dattewell/center-cluster-esp32-p4/README.md

## Issues/bug fixes

### Older boards/revision errors

This board is P4 v1.3, builds require SELECTS_REV_LESS_V3=y.
