dattewell/center-cluster-esp32-p4/DashRPM.kicad_pcb

## KiCad design DashRPM.kicad_pcb (2026-08-12, last stored version)

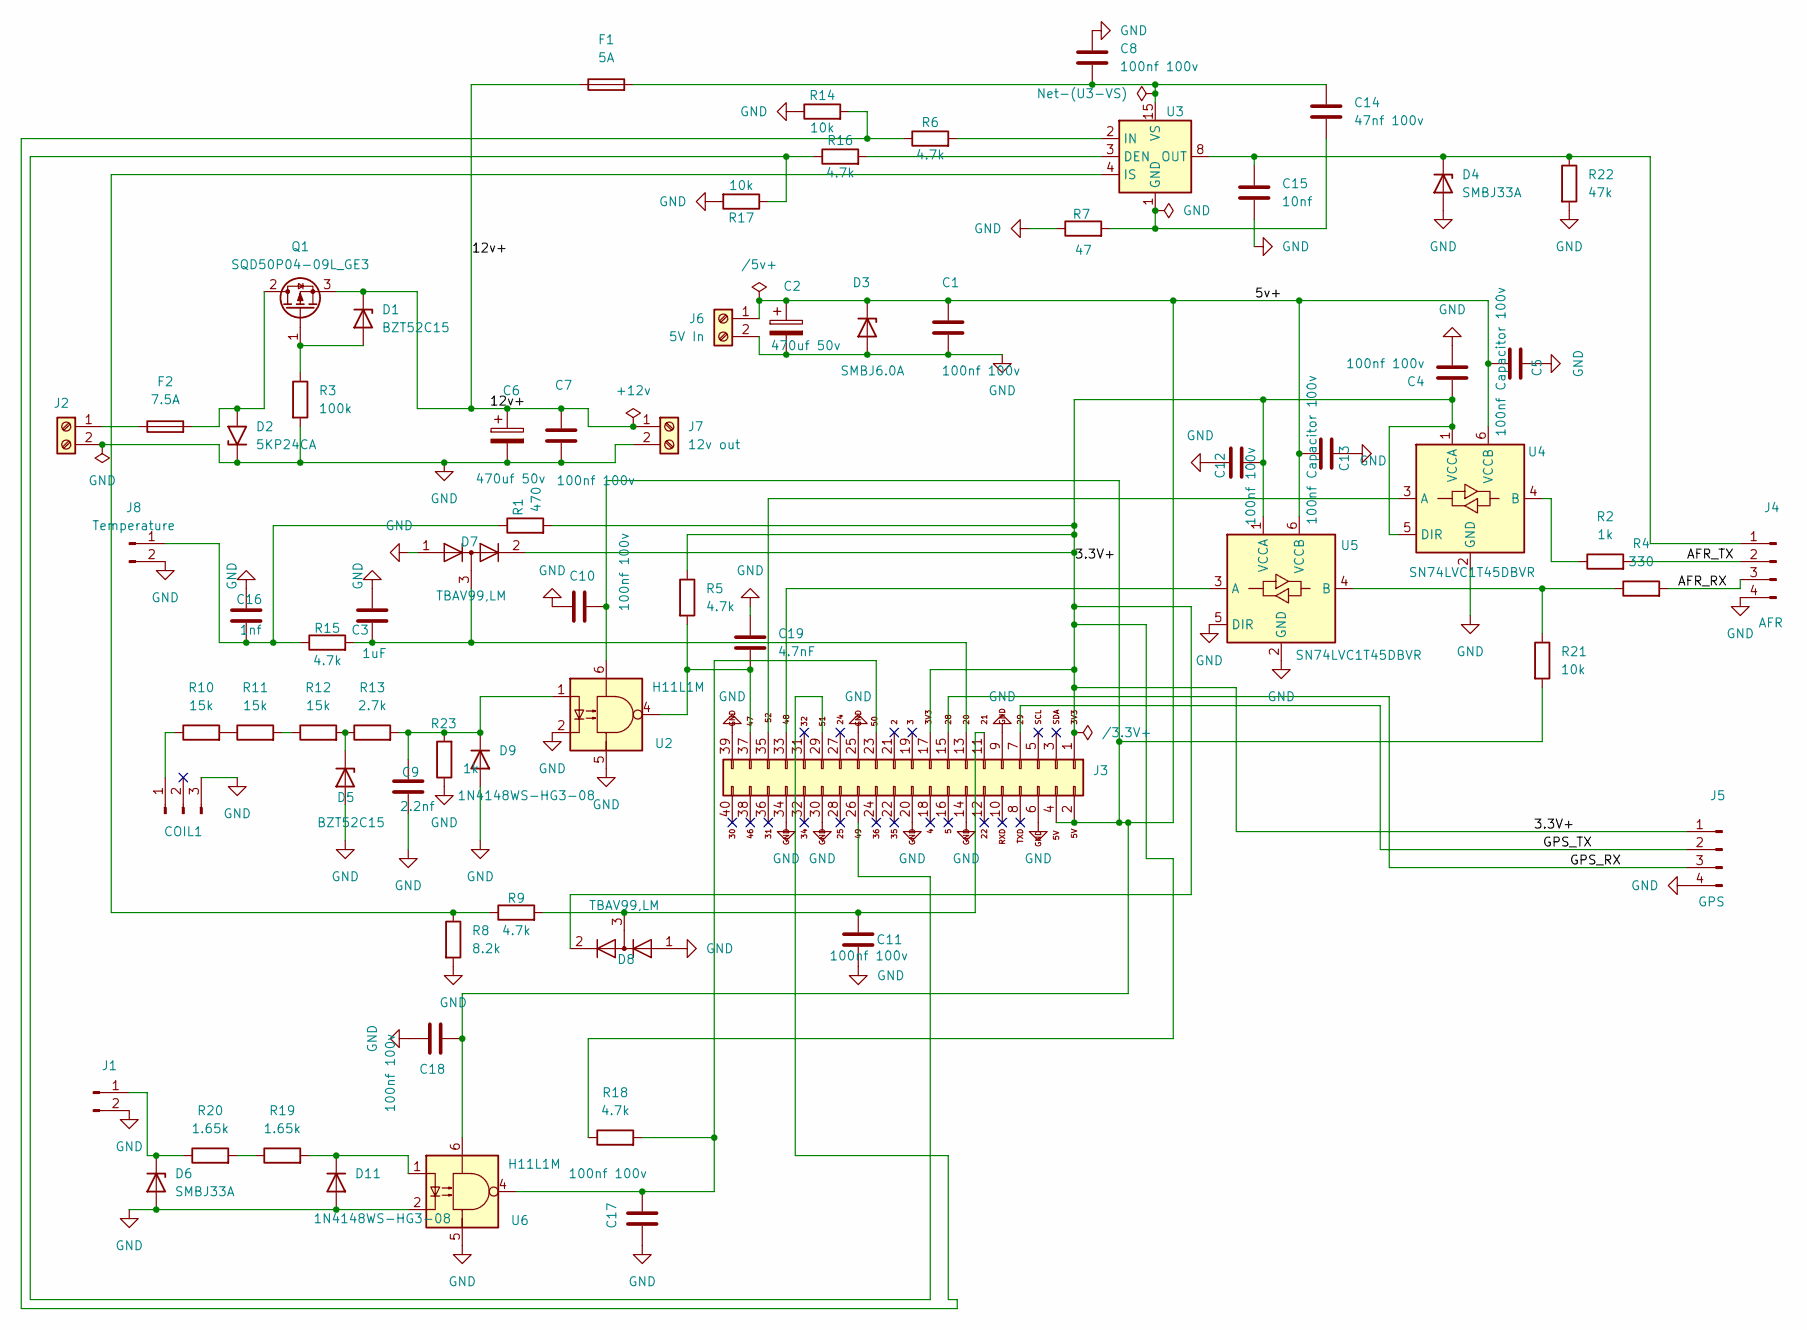
[picture p1: schematic DashRPM.kicad_sch, Morris Minor Dash Display]

Parts:
C1, C4, C5, C7, C8, C10, C11, C12, C13, C17, C18: 100nf 100v; C_0805_2012Metric; LCSC C28233
C2, C6: 470uf 50v; CP_Radial_D10.0mm_P5.00mm; LCSC C713167
C3: 1uF; C_0805_2012Metric; LCSC C28323
C9: 2.2nf; C_0805_2012Metric; LCSC C1728
C14: 47nf 100v; C_0805_2012Metric; LCSC C161267
C15: 10nf; C_0805_2012Metric; LCSC C161265
C16: 1nf; C_0805_2012Metric; LCSC C46653
C19: 4.7nF; C_0805_2012Metric; LCSC C415370
COIL1: Coil; JST_XH_B3B-XH-A_1x03_P2.50mm_Vertical; LCSC C144394
D1, D5: BZT52C15; D_SOD-123; LCSC C27754
D2: 5KP24CA; D_5KP_P12.70mm_Horizontal; LCSC C3704111
D3: SMBJ6.0A; D_SMB; LCSC C83270
D4, D6: SMBJ33A; D_SMB_Handsoldering; LCSC C224019
D7, D8: TBAV99,LM; SOT-23; LCSC C145146
D9, D11: 1N4148WS-HG3-08; D_SOD-323_HandSoldering; LCSC C3313072
F1: 5A; Fuseholder_Blade_Mini_Keystone_3568; LCSC C5249699
F2: 7.5A; Fuseholder_Blade_Mini_Keystone_3568; LCSC C5249699
J1: Headlight; JST_XH_B2B-XH-A_1x02_P2.50mm_Vertical; LCSC C158012
J2: 12v In; TerminalBlock_MaiXu_MX126-5.0-02P_1x02_P5.00mm; LCSC C3820334
J3: To Display; IDC-Header_2x20_P2.54mm_Vertical; LCSC C9138
J4: AFR; JST_VH_B4P-VH_1x04_P3.96mm_Vertical; LCSC C160317
J5: GPS; JST_XH_B4B-XH-A_1x04_P2.50mm_Vertical; LCSC C144395
J6: 5V In; TerminalBlock_MaiXu_MX126-5.0-02P_1x02_P5.00mm; LCSC C3820334
J7: 12v out; TerminalBlock_MaiXu_MX126-5.0-02P_1x02_P5.00mm; LCSC C3820334
J8: Temperature; JST_XH_B2B-XH-A_1x02_P2.50mm_Vertical; LCSC C158012
Q1: SQD50P04-09L_GE3; TO-252-3_TabPin2; LCSC C5160151
R1: 470; R_0805_2012Metric_Pad1.20x1.40mm_HandSolder; LCSC C491182
R2, R23: 1k; R_0805_2012Metric_Pad1.20x1.40mm_HandSolder; LCSC C191555
R3: 100k; R_0805_2012Metric_Pad1.20x1.40mm_HandSolder; LCSC C191554
R4: 330; R_0805_2012Metric_Pad1.20x1.40mm_HandSolder; LCSC C2479687
R5, R6, R9, R15, R16, R18: 4.7k; R_0805_2012Metric_Pad1.20x1.40mm_HandSolder; LCSC C473295
R7: 47; R_0805_2012Metric_Pad1.20x1.40mm_HandSolder; LCSC C490799
R8: 8.2k; R_0805_2012Metric_Pad1.20x1.40mm_HandSolder; LCSC C445657
R10, R11, R12: 15k; R_2512_6332Metric_Pad1.40x3.35mm_HandSolder; LCSC C965951
R13: 2.7k; R_0805_2012Metric_Pad1.20x1.40mm_HandSolder; LCSC C409999
R14, R17: 10k; R_1206_3216Metric_Pad1.30x1.75mm_HandSolder; LCSC C6492313
R19, R20: 1.65k; R_1206_3216Metric_Pad1.30x1.75mm_HandSolder; LCSC C2482762
R21: 10k; R_0805_2012Metric_Pad1.20x1.40mm_HandSolder; LCSC C191101
R22: 47k; R_0805_2012Metric_Pad1.20x1.40mm_HandSolder; LCSC C441957
U2, U6: H11L1M; SMDIP-6_W7.62mm; LCSC C16587
U3: BTS7004-1EPP; Infineon_PG-TSDSO-14-22; LCSC C534825
U4, U5: SN74LVC1T45DBVR; SOT-23-6; LCSC C7843

Connections:
/3.3V+: C4.1, C12.1, D7.2 (A), D8.2 (A), J3.1 (3V3), J3.17 (3V3), J5.1, R1.2, R5.1, R18.1, U4.1 (VCCA), U4.5 (DIR), U5.1 (VCCA)
/5v+: C1.1, C2.1, C5.2, C10.2, C13.2, C18.1, D3.1 (K), J3.2 (5V), J3.4 (5V), J6.1, R21.2, U2.6, U4.6 (VCCB), U5.6 (VCCB), U6.6
/12v+: C6.1, C7.1, D1.1 (K), F1.1, J7.1, Q1.3 (S)
/AFR_RX: J4.3, R4.2
/AFR_TX: J4.2, R2.2
/GPS_RX: J3.15 (28), J5.3
/GPS_TX: J3.7 (29), J5.2
GND: C1.2, C2.2, C3.1, C4.2, C5.1, C6.2, C7.2, C8.1, C9.2, C10.1, C11.1, C12.2, C13.1, C15.2, C16.1, C17.1, C18.2, C19.1, COIL1.3, D2.1 (A1), D3.2 (A), D4.2 (A), D5.2 (A), D6.2 (A), D7.1 (K), D8.1 (K), D9.2 (A), D11.2 (A), J1.2, J2.2, J3.6 (GND), J3.9 (GND), J3.14 (GND), J3.20 (GND), J3.25 (GND), J3.30 (GND), J3.34 (GND), J3.39 (GND), J4.4, J5.4, J6.2, J7.2, J8.2, R3.2, R7.1, R8.2, R14.1, R17.2, R22.2, R23.1, U2.2, U2.5, U4.2 (GND), U5.2 (GND), U5.5 (DIR), U6.2, U6.5
unnamed: COIL1.1, R10.1
unnamed: D1.2 (A), Q1.1 (G), R3.1
unnamed: D2.2 (A2), F2.2, Q1.2 (D)
unnamed: C15.1, D4.1 (K), J4.1, R22.1, U3.8 (OUT), U3.9 (OUT), U3.10 (OUT), U3.12 (OUT), U3.13 (OUT), U3.14 (OUT)
unnamed: D5.1 (K), R12.2, R13.1
unnamed: D6.1 (K), J1.1, R20.1
unnamed: C9.1, D9.1 (K), R13.2, R23.2, U2.1
unnamed: D11.1 (K), R19.2, U6.1
unnamed: F2.1, J2.1
unnamed: C3.2, D7.3 (K), J3.13 (20), R15.2
unnamed: C11.2, D8.3 (K), J3.11 (21), R9.2
unnamed: C19.2, J3.37 (47), R5.2, U2.4
unnamed: J3.33 (48), U5.3 (A)
unnamed: J3.26 (49), R16.1, R17.1
unnamed: C17.2, J3.23 (50), R18.2, U6.4
unnamed: J3.29 (51), R6.1, R14.2
unnamed: J3.35 (52), U4.3 (A)
unnamed: C16.2, J8.1, R1.1, R15.1
unnamed: R10.2, R11.1
unnamed: R11.2, R12.1
unnamed: R19.1, R20.2
unnamed: R16.2, U3.3 (DEN)
unnamed: C14.2, R7.2, U3.1 (GND)
unnamed: R6.2, U3.2 (IN)
unnamed: R8.1, R9.1, U3.4 (IS)
unnamed: C8.2, C14.1, F1.2, U3.15 (VS)
unnamed: R2.1, U4.4 (B)
unnamed: R4.1, R21.1, U5.4 (B)

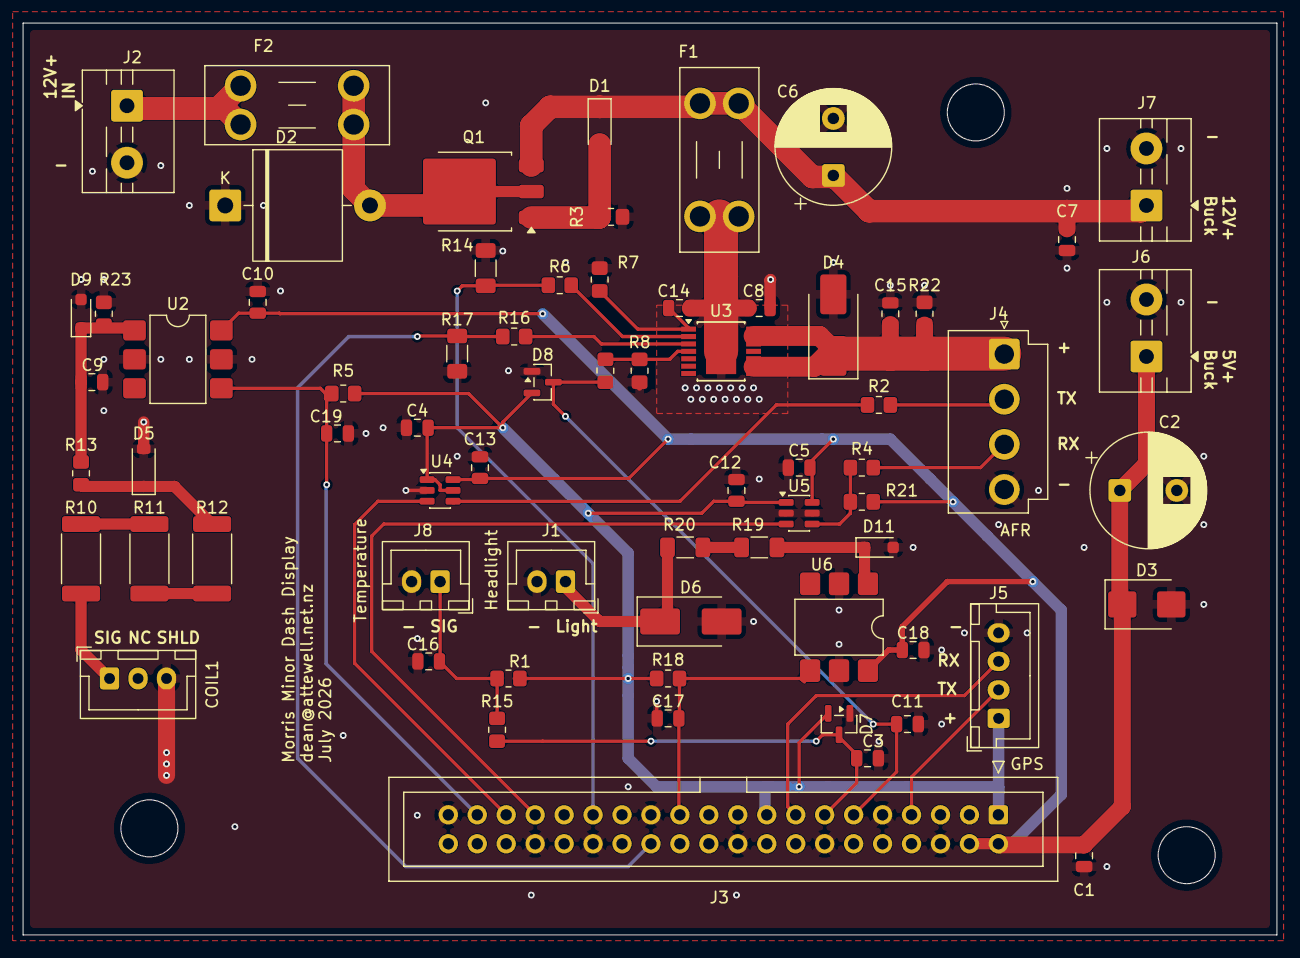
[picture p2: board DashRPM.kicad_pcb from above]

Board: 2 copper layers, 110.0 x 80.0 mm, 69 parts (0 on the bottom side), 36 nets.
