dattewell/center-cluster-esp32-p4/main/main.c

#include "freertos/FreeRTOS.h"
#include "freertos/task.h"
#include "freertos/queue.h"
#include "nvs_flash.h"
#include "nvs.h"
#include "esp_log.h"
#include "esp_err.h"
#include "esp_check.h"
#include "esp_memory_utils.h"
#include "bsp/esp-bsp.h"
#include "bsp/display.h"
#include "bsp_board_extra.h"
#include "lvgl.h"
#include "lv_demos.h"
#include "ui.h"
#include "driver/uart.h"
#include "driver/gpio.h"
#include <string.h>
#include <stdint.h>
#include <stdlib.h>
#include <stdio.h>
#include <ctype.h>
#include <math.h>
#include <time.h>
#include <unistd.h>
#include "esp_adc/adc_oneshot.h"
#include "esp_adc/adc_cali.h"
#include "esp_adc/adc_cali_scheme.h"
#include "driver/pulse_cnt.h"
#include "esp_timer.h"
#include "gps_wrapper.h"
#include "odometer/odometer.h"
#include "esp_core_dump.h"
#include "esp_flash.h"


//-------------Build / feature flags-------------//
#define ENABLE_LOGS true
#define ADC_UPDATE_PERIOD_MS 10
#define FILTER_SAMPLES_DEFAULT 8

// DEMO_MODE used to live here as a compile-time flag. It's now g_demo_mode
// (below, near g_afr_enabled) - a runtime toggle driven by ui_DemoSwitch on
// the Settings screen via ChangeDemoMode(), not a rebuild.

// Crash-dump relay + debug-log-tee to the SD card (see below). Was
// temporarily disabled (2026-08-12) while isolating a taskLVGL deadlock in
// lv_draw_add_task - root cause was LV_MEM_SIZE exhaustion (see lv_conf.h),
// unrelated to this code. Re-enabled now that's fixed.
#define SD_FEATURES_ENABLED 1
//------------------------------------------------//

//-------------GPS (u-blox M10)-------------//
// GPS RX/TX per netlist (/GPS_TX net = J3 pin 7 = GPIO29 = ESP RX;
// /GPS_RX net = J3 pin 15 = GPIO28 = ESP TX). Net names are from the
// module's perspective, so ESP_RX reads the net called GPS_TX and vice versa.
#define GPS_RX_PIN        29
#define GPS_UART_NUM      UART_NUM_3
#define GPS_TX_PIN        28
#define GPS_BAUD_RATE     38400
#define GPS_BUF_SIZE      1024
#define GPS_MIN_VALID_MPH 3.0f
//-------------------------------------------//

//-------------RPM (coil/distributor via H11L1 optoisolator) - GPIO 47-------------//
#define RPM_PULSE_GPIO       47
#define RPM_PULSES_PER_REV   2      // 4-cyl, 4-stroke: cylinders / 2
#define RPM_SAMPLE_MS        250    // how often the pulse count is turned into an RPM figure

// RPM dial angle range, calibrated against the dial artwork.
#define RPM_NEEDLE_ANGLE_0RPM     (710)
#define RPM_NEEDLE_ANGLE_MAX_RPM  (2910)
#define RPM_DIAL_MAX_RPM          6000
//----------------------------------------------------------------------------------//

//-------------Headlight sense (GPIO50) - dims the display at night-------------//
// Active LOW per the H11L1 opto (U6): HIGH = headlights off, LOW = on. Board
// already has an external 4k7 pull-up (R18), so no internal pull needed.
// Debounced in software - a bad earth or a flash-to-pass must not flicker
// the display - and brightness ramps smoothly between day/night levels
// rather than stepping, per CLAUDE.md Sec.6's suggested behaviour.
#define HEADLIGHT_GPIO          50
#define HEADLIGHT_DEBOUNCE_MS   300
#define BRIGHTNESS_DAY_PCT      50   // matches the existing boot default
#define BRIGHTNESS_NIGHT_PCT    40
#define BRIGHTNESS_RAMP_MS      1000
//--------------------------------------------------------------------------------//

//-------------AFR power gating (BTS7004 on GPIO51)-------------//
// The AFR UART level shifter used to be a single TXB0104D with a
// software-controlled OE pin (AFR_OE_GPIO, was GPIO28). The schematic now
// uses two single-bit SN74LVC1T45 shifters (one per UART direction) with
// their DIR pins hardwired to GND - fixed-direction, no enable pin at all,
// so translation just follows whichever side has power. That power already
// comes from the same BTS7004 rail this gate switches, so there's nothing
// left for a GPIO to enable here.
//
// GPIO51 drives U3 (BTS7004-1EPP) pin 2, IN, per netlist (Net-(J3-51):
// R14.2, R6.1 -> U3.2). GPIO4 was tried earlier and is physically
// unconnected on this board (terminates at J3 pin 18, no further net) - it
// would have silently done nothing.
#define AFR_ENABLE_GPIO      51     // BTS7004-1EPP IN - powers the AFR sensor
// Not yet wired into control logic - defined for when DEN/IS support is added.
#define AFR_DEN_GPIO         49     // BTS7004-1EPP DEN - HIGH enables IS output
#define AFR_IS_ADC_CHANNEL   ADC_CHANNEL_5  // BTS7004-1EPP IS, ADC1_CH5 (GPIO21)
#define RPM_MIN_RUNNING      500    // must be at/above this to start qualifying AFR power-on
#define RPM_QUALIFY_MS       30000  // sustained duration above RPM_MIN_RUNNING before AFR powers on
#define RPM_STOPPED_BELOW    100    // below this is treated as "engine stopped", not just idling low
#define RPM_STOPPED_HOLD_MS  5000   // sustained duration below RPM_STOPPED_BELOW before AFR powers back off
//-------------------------------------------------------------------------------------//

//-------------AFR UART (14point7 Spartan)-------------//
// TX/RX assignment per schematic: AFR_TX on U4 (GPIO52), AFR_RX on U5 (GPIO48).
#define AFR_UART_NUM   UART_NUM_1
#define AFR_TX_PIN     52
#define AFR_RX_PIN     48
#define AFR_BAUD_RATE  9600
//--------------------------------------------------------------------//

//-------------ADC (shared by coolant temp + PROFET current sense, both ADC1)-------------//
#define ADC_WIDTH ADC_BITWIDTH_12
#define ADC_ATTEN ADC_ATTEN_DB_12
//------------------------------------------------------------------------------------------//

//-------------Coolant temperature (GPIO20 / ADC1_CH4)-------------//
// Coolant temp - GPIO20, ADC1_CHANNEL4, per netlist (Net-(J3-20): C3.2,
// D7.3, R15.2). Confirmed on ADC1, not ADC2.
#define WATER_TEMP_ADC_CHANNEL ADC_CHANNEL_4
#define TEMP_UPDATE_DELAY 250 // 4 updates a second

// Sender node: SENSOR_SUPPLY --[R_PULLUP]-- (node, straight into the ADC pin,
// no external divider) --[sender]-- GND, with a 100nF cap on the node for
// noise filtering. R_PULLUP is R1, ERJU6RD4700V (470R) per netlist/BOM -
// confirmed authoritative over both the 1k the schematic trace suggested and
// the 10k firmware previously assumed.
#define R_PULLUP       470.0f
#define SENSOR_SUPPLY  3.3f

// NTC Beta-model conversion per CLAUDE.md Sec.3 - sender is R25=730R,
// Beta=3763 (25/85C). Physics-based, accurate across the sender's whole
// -10C to 120C+ range, unlike a table fitted only to a handful of measured
// points.
#define TEMP_R25_OHMS   730.0f
#define TEMP_BETA       3763.0f
#define TEMP_T0_KELVIN  298.15f

// Fault detection thresholds — derived from R_PULLUP = 470R.
// A working sender at -10C reads ~2946 mV, so 3000 would false-trigger;
// 3150 keeps clean margin below that while still catching a genuine open
// (~3300 mV). Coldest expected reading is ~2.95 V (-10 C); hottest ~0.12 V (150 C).
#define TEMP_OPEN_MV    3150    // sender disconnected / broken wire
#define TEMP_SHORT_MV     40    // sender or wire shorted to ground
#define TEMP_R_INVALID  -1.0f
//--------------------------------------------------------------------//

//-------------Speedo (mph) needle angles-------------//
// Matches the initial lv_image_set_rotation() set on ui_SpeedoNeedle in ui_MainSpeedo.c (0 mph rest position).
#define SPEEDO_NEEDLE_REST_ANGLE   (-670)
// How far the sweep rotates from rest before returning; sign/magnitude tuned by eye
// against the dial artwork to land near the 80 mph mark, since this needle has no
// existing mph->angle calibration to derive it from.
#define SPEEDO_SWEEP_ANGLE_DELTA   (2455)
// Needle angle at 80 mph (the top of the dial's marked scale) for live gauge
// readings - distinct from SPEEDO_SWEEP_ANGLE_DELTA above, which deliberately
// overshoots past this for the boot-time sweep flourish.
#define SPEEDO_NEEDLE_ANGLE_80MPH  (2110)
//------------------------------------------------------//

//-------------LOGGING------------//
static const char *TAG_TEMP = "TEMP_SENSOR";
static const char *TAG_GPS = "GPS_SENSOR";
static const char *TAG_AFR = "AFR_SENSOR";
//--------------------------------//

//------------DATA_SENT_OUT---------//
// Internal, display-friendly gauge model.  Every producer path writes these
// engineering-unit values first, then the UART packet layer scales them to the
// fixed-point protocol expected by the remote gauge display.
typedef struct {
    float water_temp_c;
    bool  water_temp_valid;  // false when the sender reads as disconnected - see TEMP_OPEN_MV/TEMP_SHORT_MV
    float afr;
    float afr_temp_c;   // wideband sensor cell temperature - drives update_afr_status()
    float speed_mph;
    int   rpm;
} gauge_data_t;

static gauge_data_t g_gauge_data;

// Set by update_afr_power_gate(), read by afr_task() - true once the AFR
// sensor's power (BTS7004) and UART level shifter (TXB0104D) are enabled.
// Deliberately NOT touched by demo mode below - this reflects the real,
// physical heater GPIO state, driven only by real RPM, regardless of what's
// on screen. See afr_should_display_enabled() for the display-only concern.
static volatile bool g_afr_enabled = false;

// Runtime demo-mode toggle (ui_DemoSwitch on the Settings screen, wired via
// ChangeDemoMode() below). Always starts false - deliberately not persisted
// to NVS, so a power cycle never leaves the dash stuck showing synthetic
// swept values instead of real sensor data.
static volatile bool g_demo_mode = false;

// The AFR gauge should render as "active" both when the sensor is genuinely
// powered (g_afr_enabled) and while demo mode is sweeping it for a bench
// test - but demo mode must never touch g_afr_enabled itself, since that
// also drives the real PROFET heater GPIO (see update_afr_power_gate()).
static bool afr_should_display_enabled(void) {
    return g_afr_enabled || g_demo_mode;
}


//---------------------------------------//

typedef struct {
    lv_obj_t *value_label;
    lv_obj_t *mirror_label; // optional duplicate label on another screen showing the same text, or NULL
    lv_obj_t *needle;
    const char *log_tag;
    int16_t angle_min;
    int16_t angle_max;
    int decimals;   // decimal places shown in the value label
} gauge_channel_t;

// Updates a gauge's value label(s) and needle angle together, but only if the
// displayed value actually changed (avoids redundant redraws every tick).
static void update_gauge_channel(const gauge_channel_t *ch, float new_value, int16_t angle){
    char buf[12];
    snprintf(buf, sizeof(buf), "%.*f", ch->decimals, new_value);

    // Only update text if changed
    const char *old_text = lv_label_get_text(ch->value_label);
    if (strcmp(old_text, buf) == 0) return;

    lv_label_set_text(ch->value_label, buf);
    if (ch->mirror_label) lv_label_set_text(ch->mirror_label, buf);

    if (angle > ch->angle_max) angle = ch->angle_max;
    if (angle < ch->angle_min) angle = ch->angle_min;
    #if ENABLE_LOGS
        ESP_LOGI(ch->log_tag, "value=%.1f angle=%d", new_value, angle);
    #endif
    lv_image_set_rotation(ch->needle, angle);
}

//-------------------------AFR sensor (LSU ADV) temperature status-------------------------//
// Thresholds per the LSU ADV element's operating spec: below 350C the
// controller is still waiting out the condensation phase (no valid data);
// 350-730C the heater is ramping; 730-820C is the element's rated operating
// range (AFR valid); 820-900C the heater has backed off and exhaust heat
// alone is pushing the cell hotter than rated, so AFR is still shown but
// flagged; above 900C is an alarm condition and AFR should be treated as
// unreliable.
#define AFR_TEMP_HEATING_C     350.0f
#define AFR_TEMP_OPERATING_C   730.0f
#define AFR_TEMP_WARNING_HOT_C 820.0f
#define AFR_TEMP_TOO_HOT_C     900.0f
#define AFR_ALARM_BLINK_MS     500

#define AFR_STATUS_COLOR_GOOD    0x14A604
#define AFR_STATUS_COLOR_BAD     0xF80303
#define AFR_STATUS_COLOR_WARNING 0xE0954B

typedef enum {
    AFR_TEMP_STATE_COLD,
    AFR_TEMP_STATE_HEATING,
    AFR_TEMP_STATE_OPERATING,
    AFR_TEMP_STATE_WARNING_HOT,
    AFR_TEMP_STATE_TOO_HOT,
} afr_temp_state_t;

static afr_temp_state_t afr_classify_temp(float temp_c) {
    if (temp_c < AFR_TEMP_HEATING_C)     return AFR_TEMP_STATE_COLD;
    if (temp_c < AFR_TEMP_OPERATING_C)   return AFR_TEMP_STATE_HEATING;
    if (temp_c < AFR_TEMP_WARNING_HOT_C) return AFR_TEMP_STATE_OPERATING;
    if (temp_c < AFR_TEMP_TOO_HOT_C)     return AFR_TEMP_STATE_WARNING_HOT;
    return AFR_TEMP_STATE_TOO_HOT;
}

static const char *afr_temp_state_word(afr_temp_state_t state) {
    switch (state) {
        case AFR_TEMP_STATE_COLD:        return "Cold";
        case AFR_TEMP_STATE_HEATING:      return "Heating";
        case AFR_TEMP_STATE_OPERATING:    return "Operating";
        case AFR_TEMP_STATE_WARNING_HOT:  return "Warning Hot";
        default:                          return "Too Hot";
    }
}

static uint32_t afr_temp_state_color(afr_temp_state_t state) {
    switch (state) {
        case AFR_TEMP_STATE_OPERATING:   return AFR_STATUS_COLOR_GOOD;
        case AFR_TEMP_STATE_WARNING_HOT: return AFR_STATUS_COLOR_WARNING;
        default:                         return AFR_STATUS_COLOR_BAD;
    }
}

// Converts the latest AFR reading to the AFR needle's angle range and refreshes
// the AFR label/needle (mirrored onto ui_AfrV2 on the RPM/AFR screen).
// Shows "--" instead while the AFR sensor isn't powered on at all (g_afr_enabled
// false - no sustained RPM, see update_afr_power_gate()), or blanks both labels
// whenever ui_AFRStatusBad is the one lit up (Cold/Heating/Too Hot - see
// update_afr_status()), since the reading is unreliable in all three of those
// bands, not just Too Hot. Takes the already-classified temperature state (see
// gauge_timer) rather than reclassifying it itself, since update_afr_status()
// needs the same classification.

// AFR gauge angle range, calibrated against the dial artwork.
#define AFR_GAUGE_MIN_VALUE    10.0f
#define AFR_GAUGE_MAX_VALUE    18.0f
#define AFR_NEEDLE_ANGLE_MIN   860
#define AFR_NEEDLE_ANGLE_MAX   1650

static void update_afr(float new_value, afr_temp_state_t afr_state){
    if (!afr_should_display_enabled()) {
        if (strcmp(lv_label_get_text(ui_AfrV), "--") != 0) {
            lv_label_set_text(ui_AfrV, "--");
            lv_label_set_text(ui_AfrV2, "--");
        }
        lv_obj_add_flag(ui_AfrD, LV_OBJ_FLAG_HIDDEN);
        return;
    }

    if (afr_state != AFR_TEMP_STATE_OPERATING && afr_state != AFR_TEMP_STATE_WARNING_HOT) {
        if (strcmp(lv_label_get_text(ui_AfrV), "") != 0) {
            lv_label_set_text(ui_AfrV, "");
            lv_label_set_text(ui_AfrV2, "");
        }
        lv_obj_add_flag(ui_AfrD, LV_OBJ_FLAG_HIDDEN);
        return;
    }

    lv_obj_remove_flag(ui_AfrD, LV_OBJ_FLAG_HIDDEN);
    int16_t afr_angle = (int16_t)((new_value - AFR_GAUGE_MIN_VALUE) * (AFR_NEEDLE_ANGLE_MAX - AFR_NEEDLE_ANGLE_MIN)
        / (AFR_GAUGE_MAX_VALUE - AFR_GAUGE_MIN_VALUE) + AFR_NEEDLE_ANGLE_MIN);
    gauge_channel_t ch = { .value_label = ui_AfrV, .mirror_label = ui_AfrV2, .needle = ui_AfrD, .log_tag = "AFR", .angle_min = AFR_NEEDLE_ANGLE_MIN, .angle_max = AFR_NEEDLE_ANGLE_MAX, .decimals = 1 };
    update_gauge_channel(&ch, new_value, afr_angle);
}

// Edge-detects a data source going from valid to invalid, so callers can run
// their "blank the display" step exactly once per invalid streak instead of
// every tick. Callers seed their static bool `true` so the very first call
// also forces a blank (clearing SquareLine's design-time placeholder text).
static bool valid_state_dropped(bool *was_valid, bool is_valid_now) {
    bool dropped = !is_valid_now && *was_valid;
    *was_valid = is_valid_now;
    return dropped;
}

// Converts the latest water temp reading to the temp needle's angle range and
// refreshes the temp label/needle.

// Water temp gauge angle range, calibrated against the dial artwork.
#define TEMP_GAUGE_MIN_VALUE     40.0f
#define TEMP_GAUGE_MAX_VALUE     120.0f
#define TEMP_NEEDLE_ANGLE_MIN    1950
#define TEMP_NEEDLE_ANGLE_MAX    2760

static void update_water_temp(float new_value, bool valid){
    static bool last_valid = true;

    if (valid_state_dropped(&last_valid, valid)) {
        lv_label_set_text(ui_TempV, "--");
    }
    if (!valid) {
        lv_obj_add_flag(ui_TempD, LV_OBJ_FLAG_HIDDEN);
        return;
    }

    lv_obj_remove_flag(ui_TempD, LV_OBJ_FLAG_HIDDEN);
    int16_t temp_angle = (int16_t)(TEMP_NEEDLE_ANGLE_MAX - (new_value - TEMP_GAUGE_MIN_VALUE)
        * (TEMP_NEEDLE_ANGLE_MAX - TEMP_NEEDLE_ANGLE_MIN) / (TEMP_GAUGE_MAX_VALUE - TEMP_GAUGE_MIN_VALUE));
    gauge_channel_t ch = { .value_label = ui_TempV, .mirror_label = NULL, .needle = ui_TempD, .log_tag = "TEMP", .angle_min = TEMP_NEEDLE_ANGLE_MIN, .angle_max = TEMP_NEEDLE_ANGLE_MAX, .decimals = 0 };
    update_gauge_channel(&ch, new_value, temp_angle);
}

// Converts the latest RPM reading to the RPM dial's angle range and refreshes
// the RPM label/needle.
static void update_rpm(int rpm){
    int16_t rpm_angle = (int16_t)(RPM_NEEDLE_ANGLE_0RPM +
        (int32_t)rpm * (RPM_NEEDLE_ANGLE_MAX_RPM - RPM_NEEDLE_ANGLE_0RPM) / RPM_DIAL_MAX_RPM);
    gauge_channel_t ch = { .value_label = ui_RpmV, .mirror_label = NULL, .needle = ui_RpmD, .log_tag = "RPM", .angle_min = RPM_NEEDLE_ANGLE_0RPM, .angle_max = RPM_NEEDLE_ANGLE_MAX_RPM, .decimals = 0 };
    update_gauge_channel(&ch, rpm, rpm_angle);
}

// Drives the three AFR sensor-temperature widgets from one classification:
//  - ui_AFRStatusBad: "Cold"/"Heating" (red) below the rated range, blinking
//    "Too Hot" (red) above it, blank in between (Operating/Warning Hot).
//  - ui_AFRStatusGood: "Operating" (green) in the rated range, "Warning Hot"
//    (amber) just above it (AFR still valid but flagged), blank otherwise.
//  - ui_AFRStatus: always-on combined "<state>\n<temp>C" readout, one word
//    per band (Cold/Heating/Operating/Warning Hot/Too Hot) colored to match.
// All three are blanked outright while the AFR sensor isn't powered on at all
// (g_afr_enabled false - no sustained RPM, see update_afr_power_gate()), since
// there's no real temperature reading to classify yet. Takes the
// already-classified state (see gauge_timer) since update_afr() needs the
// same classification - no need to derive it twice per tick.
static void update_afr_status(float temp_c, afr_temp_state_t state) {
    // ui_AFRStatusBad and ui_AFRStatusGood's dedupe checks always land on the
    // same "did the state change since last call" answer, so one tracker
    // covers both - only was_enabled needs to stay separate (see below).
    static afr_temp_state_t last_state = (afr_temp_state_t)-1;
    static bool blink_on = false;
    static int64_t last_blink_ms = 0;
    static char last_status_text[24] = "";
    // Starts true so the very first call (with g_afr_enabled still false at
    // boot) forces an initial blank, clearing SquareLine's design-time
    // placeholder text ("Heating\n360C" etc.) instead of leaving it on-screen
    // until the sensor happens to cycle enabled->disabled once. Kept distinct
    // from last_state (rather than checking last_state == -1) because that
    // sentinel is also last_state's own "unset" value - collapsing the two
    // would suppress this initial forced blank.
    static bool was_enabled = true;

    if (valid_state_dropped(&was_enabled, afr_should_display_enabled())) {
        lv_label_set_text(ui_AFRStatusGood, "");
        lv_label_set_text(ui_AFRStatusBad, "");
        lv_label_set_text(ui_AFRStatus, "");
        last_state = (afr_temp_state_t)-1;
        last_status_text[0] = '\0';
    }
    if (!afr_should_display_enabled()) return;

    bool state_changed = (state != last_state);
    #if ENABLE_LOGS
        if (state_changed) {
            ESP_LOGI(TAG_AFR, "temp state %d -> %d (%.0fC)", last_state, state, temp_c);
        }
    #endif

    // ui_AFRStatusBad: Cold/Heating shown solid, Too Hot blinks as an alarm,
    // Operating/Warning Hot leave it blank.
    if (state == AFR_TEMP_STATE_COLD || state == AFR_TEMP_STATE_HEATING) {
        if (state_changed) {
            lv_label_set_text(ui_AFRStatusBad, afr_temp_state_word(state));
        }
    } else if (state == AFR_TEMP_STATE_TOO_HOT) {
        int64_t now_ms = esp_timer_get_time() / 1000;
        if (now_ms - last_blink_ms >= AFR_ALARM_BLINK_MS) {
            last_blink_ms = now_ms;
            blink_on = !blink_on;
            lv_label_set_text(ui_AFRStatusBad, blink_on ? "Too Hot" : "");
        }
    } else if (state_changed) {
        lv_label_set_text(ui_AFRStatusBad, "");
    }

    // ui_AFRStatusGood: Operating/Warning Hot shown, blank otherwise.
    if (state_changed) {
        if (state == AFR_TEMP_STATE_OPERATING || state == AFR_TEMP_STATE_WARNING_HOT) {
            lv_label_set_text(ui_AFRStatusGood, afr_temp_state_word(state));
            lv_obj_set_style_text_color(ui_AFRStatusGood, lv_color_hex(afr_temp_state_color(state)), LV_PART_MAIN | LV_STATE_DEFAULT);
        } else {
            lv_label_set_text(ui_AFRStatusGood, "");
        }
    }
    last_state = state;

    // ui_AFRStatus: always-on combined readout.
    char status_text[24];
    snprintf(status_text, sizeof(status_text), "%s\n%.0f\xC2\xB0" "C", afr_temp_state_word(state), temp_c);
    if (strcmp(status_text, last_status_text) != 0) {
        lv_label_set_text(ui_AFRStatus, status_text);
        lv_obj_set_style_text_color(ui_AFRStatus, lv_color_hex(afr_temp_state_color(state)), LV_PART_MAIN | LV_STATE_DEFAULT);
        strncpy(last_status_text, status_text, sizeof(last_status_text) - 1);
        last_status_text[sizeof(last_status_text) - 1] = '\0';
    }
}
//--------------------------------------------------------------------------------------------//

// Updates one odometer digit label, but only if it differs from what's
// currently shown.
static void update_odo_if_needed(lv_obj_t *label, int digit) {
    char new_value[2] = { (char)('0' + digit), '\0' };
    const char *old_text = lv_label_get_text(label);
    if (strcmp(old_text, new_value) != 0) {
        #if ENABLE_LOGS
            ESP_LOGI("ODOMETER", "old_text=%s new_value=%s", old_text, new_value);
        #endif
        lv_label_set_text(label, new_value);
    }
}

//-----------------------TEMP--------------------------//

float read_temp_resistance(int millivolts) {
    if (millivolts >= TEMP_OPEN_MV || millivolts <= TEMP_SHORT_MV) {
        return TEMP_R_INVALID;
    }
    float v = millivolts / 1000.0f;
    return R_PULLUP * (v / (SENSOR_SUPPLY - v));
}

//-----------------------------------------------------//

void update_odometer(int miles) {
    static int last_miles = -1;
    if (miles != last_miles) {
        last_miles = miles;
        #if ENABLE_LOGS
            ESP_LOGI("ODOMETER", "miles=%d", miles);
        #endif    // Loop through each of the 6 odometer labels and update them with the corresponding digit
        lv_obj_t *odo_labels[6] = {
            ui_Odometer1, ui_Odometer2, ui_Odometer3, ui_Odometer4, ui_Odometer5, ui_Odometer6
        };
        int divisor = 100000;  // hundred-thousands down to units
        for (int i = 0; i < 6; i++) {
            update_odo_if_needed(odo_labels[i], (miles / divisor) % 10);
            divisor /= 10;
        }
    }
}

// km/h gauge angle range, calibrated against the dial artwork. Needle angle
// decreases as speed increases (starts at KMH_NEEDLE_ANGLE_MAX for 0 km/h).
#define KMH_GAUGE_MAX_VALUE     105.0f
#define KMH_NEEDLE_ANGLE_MIN    -590
#define KMH_NEEDLE_ANGLE_MAX    615

// Refreshes the mph/km-h speed labels and needles. Shows "--" on both while
// GPS has no fix, since a stale/zero speed reading would otherwise look like
// a real value; and de-jitters near-zero GPS noise by treating anything
// below GPS_MIN_VALID_MPH as stationary.
void update_speedo(float speed_mph, bool has_fix) {
    static int last_speed = -1;
    static bool last_fix = true;

    if (valid_state_dropped(&last_fix, has_fix)) {
        lv_label_set_text(ui_SpeedoValue, "--");
        lv_label_set_text(ui_SpeedV, "--");
        lv_label_set_text(ui_SpeedV2, "--");
        // Needles otherwise stay frozen at whatever angle they last showed
        // (e.g. mid-sweep from demo mode) instead of returning to 0, since
        // the angle update below is skipped entirely once !has_fix returns.
        lv_image_set_rotation(ui_SpeedoNeedle, SPEEDO_NEEDLE_REST_ANGLE);
        lv_image_set_rotation(ui_SpeedD, KMH_NEEDLE_ANGLE_MAX);
        last_speed = -1;   // force a redraw once the fix comes back
    }
    if (!has_fix) return;

    if (speed_mph < GPS_MIN_VALID_MPH) speed_mph = 0.0f;
    int speed_int = (int)speed_mph;

    if (speed_int != last_speed) {
        int16_t mph_angle = (int16_t)(SPEEDO_NEEDLE_REST_ANGLE +
            speed_mph * (SPEEDO_NEEDLE_ANGLE_80MPH - SPEEDO_NEEDLE_REST_ANGLE) / 80);
        gauge_channel_t ch = { .value_label = ui_SpeedoValue, .mirror_label = NULL, .needle = ui_SpeedoNeedle, .log_tag = "Mph_Speed", .angle_min = SPEEDO_NEEDLE_REST_ANGLE, .angle_max = SPEEDO_NEEDLE_ANGLE_80MPH, .decimals = 0 };
        update_gauge_channel(&ch, speed_mph, mph_angle);

        int speed_kmh = (int)(speed_mph * 1.609344f);
        int16_t kmh_angle = (int16_t)(KMH_NEEDLE_ANGLE_MAX
            + speed_kmh * (KMH_NEEDLE_ANGLE_MIN - KMH_NEEDLE_ANGLE_MAX) / KMH_GAUGE_MAX_VALUE);
        gauge_channel_t ch2 = { .value_label = ui_SpeedV, .mirror_label = ui_SpeedV2, .needle = ui_SpeedD, .log_tag = "Kmh_Speed", .angle_min = KMH_NEEDLE_ANGLE_MIN, .angle_max = KMH_NEEDLE_ANGLE_MAX, .decimals = 0 };
        update_gauge_channel(&ch2, speed_kmh, kmh_angle );

        last_speed = speed_int;
    }
}

// Defined further down alongside the rest of the GPS/timezone handling;
// forward-declared here so gauge_timer (and update_gps_time_display) can use it.
static bool gps_get_nz_local_time(struct tm *out_nz_tm);

// Refreshes the GPS local-time labels (ui_TimeV / ui_TimeV2), blanking both
// while GPS doesn't have a valid time yet.
static void update_gps_time_display(void) {
    // Starts true so the very first call (before GPS has any fix) forces an
    // initial blank, clearing SquareLine's design-time placeholder text
    // ("16:45") instead of leaving it on-screen until GPS time happens to
    // go valid then invalid once.
    static bool last_valid = true;
    static int last_hour = -1;
    static int last_min = -1;
    static int64_t last_check_ms = 0;

    // gps_get_nz_local_time() does two setenv()+tzset() calls, which are
    // genuinely expensive - GPS time only advances ~1x/sec, so there's no
    // point paying that cost on every 10ms gauge_timer tick.
    int64_t now_ms = esp_timer_get_time() / 1000;
    if (now_ms - last_check_ms < 500) return;
    last_check_ms = now_ms;

    struct tm nz_tm;
    bool valid = gps_get_nz_local_time(&nz_tm);
    bool was_valid_before = last_valid;

    if (valid_state_dropped(&last_valid, valid)) {
        lv_label_set_text(ui_TimeV, "");
        lv_label_set_text(ui_TimeV2, "");
        last_hour = -1;
        last_min = -1;   // force a redraw once time comes back
    }
    if (!valid) return;

    // One-time real-world anchor for uptime-stamped logs (including the SD
    // debug log, which debug_log_tee_vprintf() mirrors this into automatically
    // - no SD-specific code needed here). Logged once per validity streak, not
    // every tick, same as the display update below.
    if (!was_valid_before) {
        ESP_LOGI(TAG_GPS, "GPS time acquired: %04d-%02d-%02d %02d:%02d:%02d NZT, uptime=%lldms",
                 nz_tm.tm_year + 1900, nz_tm.tm_mon + 1, nz_tm.tm_mday,
                 nz_tm.tm_hour, nz_tm.tm_min, nz_tm.tm_sec, (long long)now_ms);
    }

    if (nz_tm.tm_hour != last_hour || nz_tm.tm_min != last_min) {
        char buf[6];
        snprintf(buf, sizeof(buf), "%02d:%02d", nz_tm.tm_hour, nz_tm.tm_min);
        lv_label_set_text(ui_TimeV, buf);
        lv_label_set_text(ui_TimeV2, buf);
        last_hour = nz_tm.tm_hour;
        last_min = nz_tm.tm_min;
    }
}

// Reads the debounced headlight state and smoothly ramps display brightness
// between day/night levels (HEADLIGHT_DEBOUNCE_MS/BRIGHTNESS_RAMP_MS above).
// Re-targeting mid-ramp (e.g. a quick on/off/on) starts from wherever the
// brightness currently is, not the old target, so it never jumps.
static void update_brightness(void) {
    static bool raw_last = false;
    static bool headlights_on = false;
    static int64_t debounce_since_ms = 0;
    static int ramp_from_pct = BRIGHTNESS_DAY_PCT;
    static int ramp_to_pct = BRIGHTNESS_DAY_PCT;
    static int64_t ramp_start_ms = 0;
    static int last_applied_pct = -1;

    int64_t now_ms = esp_timer_get_time() / 1000;
    bool raw_on = (gpio_get_level(HEADLIGHT_GPIO) == 0);   // active LOW

    if (raw_on != raw_last) {
        raw_last = raw_on;
        debounce_since_ms = now_ms;
    }

    int64_t elapsed = now_ms - ramp_start_ms;
    int current_pct = (elapsed >= BRIGHTNESS_RAMP_MS)
        ? ramp_to_pct
        : ramp_from_pct + (int)((int64_t)(ramp_to_pct - ramp_from_pct) * elapsed / BRIGHTNESS_RAMP_MS);

    if ((now_ms - debounce_since_ms) >= HEADLIGHT_DEBOUNCE_MS && raw_on != headlights_on) {
        headlights_on = raw_on;
        ramp_from_pct = current_pct;
        ramp_to_pct = headlights_on ? BRIGHTNESS_NIGHT_PCT : BRIGHTNESS_DAY_PCT;
        ramp_start_ms = now_ms;
        current_pct = ramp_from_pct;
        #if ENABLE_LOGS
            ESP_LOGI("BRIGHTNESS", "headlights_on=%d -> ramping %d%% to %d%%", headlights_on, ramp_from_pct, ramp_to_pct);
        #endif
    }

    if (current_pct != last_applied_pct) {
        bsp_display_brightness_set(current_pct);
        last_applied_pct = current_pct;
    }
}

void gauge_timer(lv_timer_t * t) {
    // UI-only timer.  Sensor tasks update shared state; this timer formats the
    // values for LVGL and smooths visual movement such as the RPM arc.

    //update ODOMETER
    int miles = odometer_get_miles();
    update_odometer(miles);

    // update brightness (headlight sense)
    update_brightness();

    // update AFR
    afr_temp_state_t afr_state = afr_classify_temp(g_gauge_data.afr_temp_c);
    update_afr(g_gauge_data.afr, afr_state);
    update_afr_status(g_gauge_data.afr_temp_c, afr_state);

    //update temp
    update_water_temp(g_gauge_data.water_temp_c, g_gauge_data.water_temp_valid);

    //update speed
    update_speedo(g_gauge_data.speed_mph, g_demo_mode ? true : gps_has_fix());

    //update RPM
    update_rpm(g_gauge_data.rpm);

    //update GPS time
    update_gps_time_display();
}

//------------------------------------------------------------------------//



// NTC Beta-model conversion (CLAUDE.md Sec.3): R25=730R, Beta=3763.
float resistance_to_C(float R) {
    float inv_t = 1.0f / TEMP_T0_KELVIN + logf(R / TEMP_R25_OHMS) / TEMP_BETA;
    return 1.0f / inv_t - 273.15f;
}



//---------------------------------GPS------------------------//

void save_miles_task(void *arg){
    // Persisting every meter would wear NVS quickly.  The odometer module only
    // commits after its distance threshold, and this task gives it regular
    // chances to do that work.
    while (1){
        odometer_periodic_save();
        vTaskDelay(pdMS_TO_TICKS(3000));
    }
}

//-------------------------------AFR (14point7 Spartan)-------------------------------//
#define AFR_POLL_PERIOD_MS      200
#define AFR_RESPONSE_TIMEOUT_MS 300

// GETDEFINITIONS replies with one line per field, not a single field-name
// list, e.g.:
//   0,a,i,-,A/F,14P7 A/F,AFR,7,20,
//   1,a,i,-,LSU T,14P7 LSU T,C,710,850,
//   2,a,i,-,DebugAIC,14P7 DbgAIC,,1,100,
//   3,a,i,-,DebugIp,14P7 DbgIp,,1,100
// as <index>,<type>,<io>,<->,<short_name>,<long_name>,<unit>,<min>,<max>,
// The leading index is exactly the field index used by "G" below, so rather
// than inferring order from text position, this just remembers which line's
// index mentioned "A/F"/"AFR" (or "LSU" for the sensor cell temperature).
// Not every unit necessarily has a channel called that, so these defaults
// (matching the real capture above) are kept as a fallback.
static int afr_field_index = 0;
static int afr_temp_field_index = 1;

// Case-insensitive substring search. Not using strcasestr() here - it isn't
// reliably declared by this toolchain's <string.h> without extra feature-test
// macros (the same issue bit timegm() earlier), so a small hand-rolled
// version avoids that risk entirely.
static const char *afr_stristr(const char *haystack, const char *needle) {
    if (!*needle) return haystack;
    for (; *haystack; haystack++) {
        const char *h = haystack;
        const char *n = needle;
        while (*h && *n && tolower((unsigned char)*h) == tolower((unsigned char)*n)) {
            h++;
            n++;
        }
        if (!*n) return haystack;
    }
    return NULL;
}

// Scans a (possibly multi-line) GETDEFINITIONS reply for the lines describing
// the AFR and sensor-temperature channels and records their indices. Logs
// what it found either way.
static void afr_parse_definitions(const char *text) {
    char copy[400];
    strncpy(copy, text, sizeof(copy) - 1);
    copy[sizeof(copy) - 1] = '\0';

    char *saveptr = NULL;
    char *line = strtok_r(copy, "\r\n", &saveptr);
    bool found_afr = false, found_temp = false;

    while (line != NULL) {
        if (!found_afr && (afr_stristr(line, "A/F") || afr_stristr(line, "AFR"))) {
            afr_field_index = atoi(line);
            found_afr = true;
            #if ENABLE_LOGS
                ESP_LOGI(TAG_AFR, "Discovered AFR field at index %d: %s", afr_field_index, line);
            #endif
        } else if (!found_temp && afr_stristr(line, "LSU")) {
            afr_temp_field_index = atoi(line);
            found_temp = true;
            #if ENABLE_LOGS
                ESP_LOGI(TAG_AFR, "Discovered sensor temp field at index %d: %s", afr_temp_field_index, line);
            #endif
        }
        line = strtok_r(NULL, "\r\n", &saveptr);
    }

    #if ENABLE_LOGS
        if (!found_afr) {
            ESP_LOGW(TAG_AFR, "GETDEFINITIONS didn't mention A/F or AFR - keeping default field index %d", afr_field_index);
        }
        if (!found_temp) {
            ESP_LOGW(TAG_AFR, "GETDEFINITIONS didn't mention LSU temp - keeping default field index %d", afr_temp_field_index);
        }
    #endif
}

typedef struct {
    bool afr_valid;
    float afr;
    bool temp_valid;
    float temp_c;
} afr_reading_t;

// "G" replies with one line per field too, as <index>:<type>:<value>, e.g.:
//   0:a:50.0
//   1:a:780
//   2:a:4789
//   3:a:2242
// This scans those lines for the ones matching afr_field_index/afr_temp_field_index
// (as found by afr_parse_definitions()) and returns their values.
static bool afr_parse_g_response(const char *text, afr_reading_t *out) {
    out->afr_valid = false;
    out->temp_valid = false;

    char copy[400];
    strncpy(copy, text, sizeof(copy) - 1);
    copy[sizeof(copy) - 1] = '\0';

    char *saveptr = NULL;
    char *line = strtok_r(copy, "\r\n", &saveptr);

    while (line != NULL) {
        int idx;
        char type;
        float value;
        if (sscanf(line, "%d:%c:%f", &idx, &type, &value) == 3) {
            if (idx == afr_field_index) {
                out->afr = value;
                out->afr_valid = true;
            } else if (idx == afr_temp_field_index) {
                out->temp_c = value;
                out->temp_valid = true;
            }
        }
        line = strtok_r(NULL, "\r\n", &saveptr);
    }
    return out->afr_valid || out->temp_valid;
}

// Sends an AFR command and waits for its reply, returning the number of
// bytes received (0 on timeout) with buf null-terminated either way.
static int afr_send_command(const char *cmd, uint8_t *buf, size_t buf_size) {
    uart_write_bytes(AFR_UART_NUM, cmd, strlen(cmd));
    int len = uart_read_bytes(AFR_UART_NUM, buf, buf_size - 1, pdMS_TO_TICKS(AFR_RESPONSE_TIMEOUT_MS));
    if (len < 0) len = 0;
    buf[len] = '\0';
    return len;
}

// Sends an AFR setup command and logs its reply under `tag`, if any.
static void afr_send_and_log(const char *cmd, const char *tag, uint8_t *buf, size_t buf_size) {
    if (afr_send_command(cmd, buf, buf_size) > 0) {
        #if ENABLE_LOGS
            ESP_LOGI(TAG_AFR, "%s: %s", tag, (char *)buf);
        #endif
    }
}

void afr_task(void *arg) {
    // Request/response protocol, not a continuous stream: only talks to the
    // Spartan while g_afr_enabled (set by update_afr_power_gate once RPM has
    // qualified). On the first poll after power-on, runs a one-time setup
    // sequence (identify the unit, configure slow-heat protection, and
    // discover the AFR field's index), then polls with "G" from then on.
    uint8_t buf[400];
    bool queried_definitions = false;

    while (1) {
        if (!g_afr_enabled) {
            queried_definitions = false;
            vTaskDelay(pdMS_TO_TICKS(500));
            continue;
        }

        if (!queried_definitions) {
            // Give the sensor/level shifter a moment to come up cleanly.
            vTaskDelay(pdMS_TO_TICKS(200));

            afr_send_and_log("GETHW\r\n", "GETHW", buf, sizeof(buf));
            afr_send_and_log("GETFW\r\n", "GETFW", buf, sizeof(buf));

            // Our power gate (update_afr_power_gate()) enables the sensor
            // once RPM has merely been sustained for 30s, which doesn't
            // guarantee the exhaust near the sensor bung is hot yet - this
            // tells the controller to wait (up to 10 min) for exhaust gas to
            // reach 350C before driving the heater, avoiding thermal shock.
            afr_send_and_log("SETSLOWHEAT3\r\n", "SETSLOWHEAT3", buf, sizeof(buf));

            if (afr_send_command("GETDEFINITIONS\r\n", buf, sizeof(buf)) > 0) {
                #if ENABLE_LOGS
                    ESP_LOGI(TAG_AFR, "GETDEFINITIONS: %s", (char *)buf);
                #endif
                afr_parse_definitions((char *)buf);
            } else {
                #if ENABLE_LOGS
                    ESP_LOGW(TAG_AFR, "No response to GETDEFINITIONS - keeping default field order");
                #endif
            }
            queried_definitions = true;
        }

        if (afr_send_command("G\r\n", buf, sizeof(buf)) > 0) {
            afr_reading_t reading;
            if (afr_parse_g_response((char *)buf, &reading)) {
                // Gated so a real, already-powered AFR sensor (g_afr_enabled
                // true from sustained real RPM) can't race demo_task's
                // synthetic writes to the same fields if demo mode gets
                // toggled on mid-drive. See adc_task/gps_task for the same
                // pattern.
                if (!g_demo_mode) {
                    if (reading.afr_valid)  g_gauge_data.afr = reading.afr;
                    if (reading.temp_valid) g_gauge_data.afr_temp_c = reading.temp_c;
                }
                #if ENABLE_LOGS
                    ESP_LOGI(TAG_AFR, "G: %s -> afr=%.2f temp=%.0fC", (char *)buf, g_gauge_data.afr, g_gauge_data.afr_temp_c);
                #endif
            } else {
                #if ENABLE_LOGS
                    ESP_LOGW(TAG_AFR, "Unparsable G response: %s", (char *)buf);
                #endif
            }
        }

        vTaskDelay(pdMS_TO_TICKS(AFR_POLL_PERIOD_MS));
    }
}
//--------------------------------------------------------------------------------------//

#define NZ_TZ "NZST-12NZDT-13,M9.5.0,M4.1.0/3"

// Converts a GPS UTC date/time into NZ local time (NZST/NZDT), DST included,
// using the C library's POSIX TZ rule instead of hand-rolled calendar math.
//
// newlib here doesn't expose timegm(), so instead of a direct UTC->epoch
// conversion, mktime() is used with TZ briefly forced to UTC0 (mktime()
// interprets its input using whatever the current TZ is), then TZ is
// restored to NZ time for the localtime_r() conversion. This isn't
// reentrant-safe against another task reading local time mid-call, but
// this is the only place in the app that touches TZ.
static bool gps_get_nz_local_time(struct tm *out_nz_tm) {
    if (!gps_date_valid() || !gps_time_valid()) return false;

    struct tm utc_tm = {
        .tm_year = gps_get_year() - 1900,
        .tm_mon  = gps_get_month() - 1,
        .tm_mday = gps_get_day(),
        .tm_hour = gps_get_hour(),
        .tm_min  = gps_get_minute(),
        .tm_sec  = gps_get_second(),
    };

    setenv("TZ", "UTC0", 1);
    tzset();
    time_t epoch = mktime(&utc_tm);
    setenv("TZ", NZ_TZ, 1);
    tzset();

    localtime_r(&epoch, out_nz_tm);
    return true;
}

static void uart_init(uart_port_t uart_num, int txPin, int rxPin, int bufSize, int baud) {
    // Shared UART setup for the two gauge transmit ports and the GPS receive
    // port.  Unused pins are passed as UART_PIN_NO_CHANGE.
    uart_config_t cfg = {
        .baud_rate = baud,
        .data_bits = UART_DATA_8_BITS,
        .parity    = UART_PARITY_DISABLE,
        .stop_bits = UART_STOP_BITS_1,
        .flow_ctrl = UART_HW_FLOWCTRL_DISABLE,
        .source_clk = UART_SCLK_DEFAULT 
    };

    ESP_ERROR_CHECK(uart_driver_install(
        uart_num,
        bufSize,   // RX buffer
        0,         // TX buffer
        0,
        NULL,
        0
    ));

    ESP_ERROR_CHECK(uart_param_config(uart_num, &cfg));

    ESP_ERROR_CHECK(uart_set_pin(
        uart_num,
        txPin,
        rxPin,
        UART_PIN_NO_CHANGE,
        UART_PIN_NO_CHANGE
    ));
}


// LVGL async callback: applies a formatted GPS status string to ui_GPSDEBUG.
static void gps_debug_label_cb(void *user_data) {
    lv_label_set_text(ui_GPSDEBUG, (const char *)user_data);
}

void gps_task(void *arg) {
    // Feed NMEA bytes into TinyGPS++, update the speed label asynchronously,
    // and use high-quality position updates for lap timing and odometer growth.
    uint8_t buf[128];
    static double last_lat = 0.0;
    static double last_lon = 0.0;
    static bool first_fix = true;

    while (true) {
        int len = uart_read_bytes(GPS_UART_NUM, buf, sizeof(buf), portMAX_DELAY);
        #if ENABLE_LOGS
            if (len > 0) {
                ESP_LOGI(TAG_GPS, "UART RX %d bytes: %.*s", len, len, (char *)buf);
            } else if (len < 0) {
                ESP_LOGW(TAG_GPS, "uart_read_bytes error: %d", len);
            }
        #endif
        for (int i = 0; i < len; i++) {
            gps_encode_char(buf[i]);
            gps_ubx_feed_byte(buf[i]);
        }

        bool has_fix = gps_has_fix();
        int  sats_used = gps_sats_used();
        float hdop     = gps_hdop();

        if (has_fix) {
            float new_speed = gps_get_speed_mph();
            // Odometer accumulation below stays tied to real GPS movement
            // regardless of demo mode - only the display-facing field is
            // gated, so distance travelled is never affected by what's
            // shown on screen. See adc_task for the same pattern.
            if (!g_demo_mode) g_gauge_data.speed_mph = new_speed;

            if (sats_used >= 5 && hdop < 3.5f && gps_location_updated()){
                double current_lat = gps_get_lat();
                double current_lon = gps_get_lon();
                
                //------------------------------------------------//

                if (first_fix) {
                    last_lat = current_lat;
                    last_lon = current_lon;
                    first_fix = false;
                    continue;
                }

                double meters = gps_distance_between(last_lat, last_lon, current_lat, current_lon);

                // Filter GPS jitter (very important)
                if (new_speed > GPS_MIN_VALID_MPH && meters > 0.05 && meters < 100.0) {
                    static double meter_accumulator = 0.0;

                    meter_accumulator += meters;

                    if (meter_accumulator >= 1.0) {
                        uint32_t whole = (uint32_t)meter_accumulator;
                        odometer_add_meters(whole);
                        meter_accumulator -= whole;
                    }
                }

                last_lat = current_lat;
                last_lon = current_lon;
            }


        } else {
            g_gauge_data.speed_mph = 0;
        }
        #if ENABLE_LOGS
            struct tm nz_tm = {0};
            bool have_nz_time = gps_get_nz_local_time(&nz_tm);

            ESP_LOGI(TAG_GPS,
                    "GPS Fix: %s | Speed: %.0f MPH | Sats Used: %d | HDOP: %.1f | NZ Time: %02d:%02d:%02d",
                    has_fix ? "YES" : "NO",
                    g_gauge_data.speed_mph,
                    sats_used,
                    hdop,
                    have_nz_time ? nz_tm.tm_hour : -1,
                    have_nz_time ? nz_tm.tm_min  : -1,
                    have_nz_time ? nz_tm.tm_sec  : -1);

            static char gps_debug_buf[80];
            snprintf(gps_debug_buf, sizeof(gps_debug_buf),
                    "Fix:%s\nSpd:%.0f\nSats:%d\nHDOP:%.1f\n%02d:%02d:%02d",
                    has_fix ? "Y" : "N",
                    g_gauge_data.speed_mph,
                    sats_used,
                    hdop,
                    have_nz_time ? nz_tm.tm_hour : -1,
                    have_nz_time ? nz_tm.tm_min  : -1,
                    have_nz_time ? nz_tm.tm_sec  : -1);
            lv_async_call(gps_debug_label_cb, gps_debug_buf);
        #endif
        vTaskDelay(1);
    }
}

//------------------------------------------------------------------------//


//------------------------------ADC_UART---------------------------------------//
static adc_oneshot_unit_handle_t g_adc1_handle;
static adc_cali_handle_t g_adc1_cali_handle;

static void adc_global_init(void) {
    // ADC attenuation is configured once at boot.  Individual reads below are
    // sampled and averaged per sensor to reduce noise.
    adc_oneshot_unit_init_cfg_t unit_config = {
        .unit_id = ADC_UNIT_1,
    };
    ESP_ERROR_CHECK(adc_oneshot_new_unit(&unit_config, &g_adc1_handle));

    adc_oneshot_chan_cfg_t chan_config = {
        .bitwidth = ADC_WIDTH,
        .atten = ADC_ATTEN,
    };
    ESP_ERROR_CHECK(adc_oneshot_config_channel(g_adc1_handle, WATER_TEMP_ADC_CHANNEL, &chan_config));

    // Raw ADC counts aren't linearly related to voltage, so use IDF's curve-fitting
    // calibration to get real millivolts instead of a hand-rolled reference constant.
    adc_cali_curve_fitting_config_t cali_config = {
        .unit_id = ADC_UNIT_1,
        .chan = WATER_TEMP_ADC_CHANNEL,
        .atten = ADC_ATTEN,
        .bitwidth = ADC_WIDTH,
    };
    ESP_ERROR_CHECK(adc_cali_create_scheme_curve_fitting(&cali_config, &g_adc1_cali_handle));

    #if ENABLE_LOGS
        ESP_LOGI("ADC", "ADC Global Init Complete");
    #endif
}

// Averages `samples` raw ADC reads, then converts the average to a calibrated
// millivolt reading.
int sample_sum_adc1_mv(adc_channel_t adc_channel, int samples){
    uint32_t sum = 0;
    int raw = 0;

    for (int i = 0; i < samples; i++) {
        adc_oneshot_read(g_adc1_handle, adc_channel, &raw);
        sum += raw;
    }

    int avg_raw = sum / samples;
    int millivolts = 0;
    adc_cali_raw_to_voltage(g_adc1_cali_handle, avg_raw, &millivolts);
    return millivolts;
}

// Configures GPIO 47 as a PCNT (pulse counter) input, counting rising edges
// from the ignition coil signal after the H11L1 optoisolator's clean logic
// output. RPM is derived by periodically reading and clearing this count.
static pcnt_unit_handle_t rpm_pcnt_unit = NULL;

static void rpm_pcnt_init(void) {
    pcnt_unit_config_t unit_config = {
        .high_limit = 30000,
        .low_limit = -1,
    };
    ESP_ERROR_CHECK(pcnt_new_unit(&unit_config, &rpm_pcnt_unit));

    pcnt_glitch_filter_config_t filter_config = {
        .max_glitch_ns = 1000,  // ignore sub-microsecond noise glitches
    };
    ESP_ERROR_CHECK(pcnt_unit_set_glitch_filter(rpm_pcnt_unit, &filter_config));

    pcnt_chan_config_t chan_config = {
        .edge_gpio_num = RPM_PULSE_GPIO,
        .level_gpio_num = -1,
    };
    pcnt_channel_handle_t chan = NULL;
    ESP_ERROR_CHECK(pcnt_new_channel(rpm_pcnt_unit, &chan_config, &chan));
    ESP_ERROR_CHECK(pcnt_channel_set_edge_action(chan,
        PCNT_CHANNEL_EDGE_ACTION_INCREASE, PCNT_CHANNEL_EDGE_ACTION_HOLD));

    ESP_ERROR_CHECK(pcnt_unit_enable(rpm_pcnt_unit));
    ESP_ERROR_CHECK(pcnt_unit_clear_count(rpm_pcnt_unit));
    ESP_ERROR_CHECK(pcnt_unit_start(rpm_pcnt_unit));
}

// Reads and clears the pulse count, converting it into an instantaneous RPM
// figure using the elapsed time since the last call.
static int rpm_read_and_reset(void) {
    static int64_t last_read_us = 0;
    int64_t now_us = esp_timer_get_time();
    int64_t elapsed_us = (last_read_us == 0) ? ((int64_t)RPM_SAMPLE_MS * 1000) : (now_us - last_read_us);
    last_read_us = now_us;

    int count = 0;
    pcnt_unit_get_count(rpm_pcnt_unit, &count);
    pcnt_unit_clear_count(rpm_pcnt_unit);

    if (count <= 0 || elapsed_us <= 0) return 0;

    // rpm = (pulses / pulses_per_rev) / (elapsed_us / 60e6)
    return (int)(((int64_t)count * 60000000LL) / (RPM_PULSES_PER_REV * elapsed_us));
}

// Enables the AFR sensor's power (BTS7004) - which also powers the fixed-
// direction UART level shifters' 5V side, the only "enable" they have - once
// RPM has been sustained above RPM_MIN_RUNNING for RPM_QUALIFY_MS, and keeps
// it on through brief dips - only powering back off once RPM has been
// genuinely near zero (engine stopped, not just idling low) for
// RPM_STOPPED_HOLD_MS. This avoids repeatedly power-cycling the wideband
// sensor's heater on every momentary idle fluctuation.
static void update_afr_power_gate(int rpm) {
    static int64_t qualifying_since_ms = -1;
    static int64_t stopped_since_ms = -1;
    int64_t now_ms = esp_timer_get_time() / 1000;

    if (g_afr_enabled) {
        if (rpm < RPM_STOPPED_BELOW) {
            if (stopped_since_ms < 0) stopped_since_ms = now_ms;
            if (now_ms - stopped_since_ms >= RPM_STOPPED_HOLD_MS) {
                g_afr_enabled = false;
                gpio_set_level(AFR_ENABLE_GPIO, 0);
                qualifying_since_ms = -1;
                stopped_since_ms = -1;
                #if ENABLE_LOGS
                    ESP_LOGI(TAG_AFR, "Engine stopped - AFR sensor powered off");
                #endif
            }
        } else {
            stopped_since_ms = -1;
        }
        return;
    }

    if (rpm >= RPM_MIN_RUNNING) {
        if (qualifying_since_ms < 0) qualifying_since_ms = now_ms;
        if (now_ms - qualifying_since_ms >= RPM_QUALIFY_MS) {
            g_afr_enabled = true;
            gpio_set_level(AFR_ENABLE_GPIO, 1);
            #if ENABLE_LOGS
                ESP_LOGI(TAG_AFR, "RPM sustained >= %d for %d ms - AFR sensor powered on", RPM_MIN_RUNNING, RPM_QUALIFY_MS);
            #endif
        }
    } else {
        qualifying_since_ms = -1;
    }
}

static void adc_task(void *arg) {
    // Main analog/pulse acquisition loop.  Each sensor group has its own
    // cadence so slow-changing values like temp do not waste cycles.
    //
    // Always runs, even while g_demo_mode is on - real sensors keep being
    // sampled and logged (useful diagnostic, and update_afr_power_gate()
    // must always reflect real RPM regardless of what's on screen - see
    // g_afr_enabled's comment). Only the writes into g_gauge_data that feed
    // the display are skipped while demo mode owns them, so this task and
    // demo_task never race over the same fields.
    int64_t last_temp_ms = 0;
    int64_t last_rpm_ms  = 0;
    static float water_filtered = -1;
    int last_logged_water_temp_c = INT32_MIN;
    int last_logged_rpm = INT32_MIN;


    while (1) {
        int64_t now_ms = esp_timer_get_time() / 1000;

        // ---------- Temperature Update ---------- //
        if (now_ms - last_temp_ms >= TEMP_UPDATE_DELAY) {
            last_temp_ms = now_ms;

            // Water temp (ADC1)
            int mv_water = sample_sum_adc1_mv(WATER_TEMP_ADC_CHANNEL, FILTER_SAMPLES_DEFAULT);
            float R_water = read_temp_resistance(mv_water);
            bool water_sensor_connected = (R_water != TEMP_R_INVALID);
            if (!g_demo_mode) g_gauge_data.water_temp_valid = water_sensor_connected;

            if (water_sensor_connected) {
                float water_new = resistance_to_C(R_water);

                if (water_filtered < 0) water_filtered = water_new;

                water_filtered = water_filtered * 0.95f + water_new * 0.05f;

                if (!g_demo_mode) g_gauge_data.water_temp_c = water_filtered;

                #if ENABLE_LOGS
                    int water_temp_c_int = (int)water_filtered;
                    if (water_temp_c_int != last_logged_water_temp_c) {
                        last_logged_water_temp_c = water_temp_c_int;
                        ESP_LOGI(TAG_TEMP, "Water: %.1fC", water_filtered);
                        //ESP_LOGI(TAG_TEMP, "mv_water=%d R_water=%.1f", mv_water, R_water);
                    }
                #endif
            }
        }

        // ---------- RPM / AFR power gate ---------- //
        if (now_ms - last_rpm_ms >= RPM_SAMPLE_MS) {
            last_rpm_ms = now_ms;
            int rpm = rpm_read_and_reset();
            if (!g_demo_mode) g_gauge_data.rpm = rpm;
            update_afr_power_gate(rpm);
            #if ENABLE_LOGS
                if (rpm != last_logged_rpm) {
                    last_logged_rpm = rpm;
                    ESP_LOGI("RPM", "rpm=%d", rpm);
                }
            #endif
        }

        vTaskDelay(pdMS_TO_TICKS(ADC_UPDATE_PERIOD_MS));
    }
}




//------------------------------------------------------------------------//



// LVGL animation exec callback: applies the current animated angle to the needle image.
static void speedo_needle_angle_anim_cb(void *obj, int32_t angle) {
    lv_image_set_rotation((lv_obj_t *)obj, (int16_t)angle);
}

// Plays the boot-time speedometer needle sweep (rest -> swept angle -> rest).
static void start_speedo_boot_sweep(void) {
    // One animation with playback: sweeps out over half the time, then LVGL
    // automatically reverses back to the start value over the other half.
    lv_anim_t a;
    lv_anim_init(&a);
    lv_anim_set_var(&a, ui_SpeedoNeedle);
    lv_anim_set_exec_cb(&a, speedo_needle_angle_anim_cb);
    lv_anim_set_values(&a, SPEEDO_NEEDLE_REST_ANGLE, SPEEDO_SWEEP_ANGLE_DELTA);
    lv_anim_set_time(&a, 1750);
    lv_anim_set_playback_time(&a, 1750);
    lv_anim_set_path_cb(&a, lv_anim_path_ease_in_out);
    lv_anim_start(&a);
}

//-------------------------demo mode-------------------------//
// Triangle wave 0..1..0 over period_ms, phase-shifted by an arbitrary offset
// per gauge so they don't all peak/trough together.
static float demo_wave01(int64_t now_ms, int period_ms, int phase_ms) {
    int64_t t = (now_ms + phase_ms) % period_ms;
    int64_t half = period_ms / 2;
    return (t < half) ? ((float)t / half) : ((float)(period_ms - t) / half);
}

// Always running (started unconditionally in app_main()), but only writes
// to g_gauge_data while g_demo_mode is on - toggled at runtime via
// ChangeDemoMode() (ui_DemoSwitch, Settings screen), not a compile-time
// choice anymore. Deliberately does not touch g_afr_enabled - see its
// comment and afr_should_display_enabled() for why the AFR gauge still
// sweeps correctly without this task ever touching the real heater GPIO.
static void demo_task(void *arg) {
    while (1) {
        if (g_demo_mode) {
            int64_t now_ms = esp_timer_get_time() / 1000;

            g_gauge_data.rpm = (int)(demo_wave01(now_ms, 4000, 0) * RPM_DIAL_MAX_RPM);
            g_gauge_data.speed_mph = demo_wave01(now_ms, 6000, 1500) * 80.0f;
            g_gauge_data.water_temp_valid = true;
            g_gauge_data.water_temp_c = TEMP_GAUGE_MIN_VALUE
                + demo_wave01(now_ms, 10000, 3000) * (TEMP_GAUGE_MAX_VALUE - TEMP_GAUGE_MIN_VALUE);
            g_gauge_data.afr = AFR_GAUGE_MIN_VALUE
                + demo_wave01(now_ms, 7000, 2000) * (AFR_GAUGE_MAX_VALUE - AFR_GAUGE_MIN_VALUE);
            g_gauge_data.afr_temp_c = 200.0f + demo_wave01(now_ms, 9000, 4500) * 750.0f;  // sweeps all status bands
        }

        vTaskDelay(pdMS_TO_TICKS(50));
    }
}

// Persistent "DEMO" badge, visible on every screen whenever g_demo_mode is
// on - a driver glancing at the dash must never mistake a synthetic sweep
// for real sensor data. Built on lv_layer_top(), LVGL's dedicated overlay
// layer that renders above whichever of the three SquareLine screens is
// currently active, rather than being added to each screen individually
// (which would mean hand-editing SquareLine-generated files that get
// overwritten on every re-export).
static lv_obj_t *s_demo_badge = NULL;

static void demo_badge_init(void) {
    s_demo_badge = lv_label_create(lv_layer_top());
    lv_label_set_text(s_demo_badge, "DEMO");
    lv_obj_set_style_bg_color(s_demo_badge, lv_color_hex(0xE0242B), LV_PART_MAIN | LV_STATE_DEFAULT);
    lv_obj_set_style_bg_opa(s_demo_badge, 255, LV_PART_MAIN | LV_STATE_DEFAULT);
    lv_obj_set_style_text_color(s_demo_badge, lv_color_hex(0xFFFFFF), LV_PART_MAIN | LV_STATE_DEFAULT);
    lv_obj_set_style_text_font(s_demo_badge, &lv_font_montserrat_14, LV_PART_MAIN | LV_STATE_DEFAULT);
    lv_obj_set_style_pad_hor(s_demo_badge, 10, LV_PART_MAIN | LV_STATE_DEFAULT);
    lv_obj_set_style_pad_ver(s_demo_badge, 4, LV_PART_MAIN | LV_STATE_DEFAULT);
    lv_obj_set_style_radius(s_demo_badge, 6, LV_PART_MAIN | LV_STATE_DEFAULT);
    lv_obj_align(s_demo_badge, LV_ALIGN_TOP_MID, 0, 6);
    lv_obj_add_flag(s_demo_badge, LV_OBJ_FLAG_HIDDEN);   // g_demo_mode starts false
}

// Wired to ui_DemoSwitch (Settings screen) via ui_event_DemoSwitch() in the
// SquareLine-generated ui_Settings.c, which calls this on LV_EVENT_PRESSED -
// touch-down. lv_switch has its own built-in click-to-toggle behavior that
// runs independently and fires LV_EVENT_VALUE_CHANGED once the toggle
// actually settles - manually writing LV_STATE_CHECKED here as well (an
// earlier version of this did) fights that internal logic through an
// uncoordinated second path, which was producing both a visibly out-of-sync
// switch and, worse, apparent lockups (consistent with tripping an LVGL
// internal assert into LV_ASSERT_HANDLER's deliberate while(1) halt - see
// lv_conf.h). So this is intentionally a no-op with respect to switch/demo
// state now: demo_switch_value_changed_cb() below (LV_EVENT_VALUE_CHANGED)
// is the only thing that reads or writes g_demo_mode from the UI side.
void ChangeDemoMode(lv_event_t * e) {
}

// The actual demo-mode toggle handler - registered directly on ui_DemoSwitch
// for LV_EVENT_VALUE_CHANGED, which lv_switch fires itself once its own
// internal toggle has genuinely completed. Reads the settled state rather
// than flipping a separate flag, so there's exactly one writer of
// LV_STATE_CHECKED (LVGL's own switch logic) and exactly one reader
// (this). Also owns showing/hiding the DEMO badge, since that's a pure
// function of the now-correct g_demo_mode.
static void demo_switch_value_changed_cb(lv_event_t *e) {
    g_demo_mode = lv_obj_has_state(ui_DemoSwitch, LV_STATE_CHECKED);

    if (g_demo_mode) {
        lv_obj_remove_flag(s_demo_badge, LV_OBJ_FLAG_HIDDEN);
    } else {
        lv_obj_add_flag(s_demo_badge, LV_OBJ_FLAG_HIDDEN);
    }

    #if ENABLE_LOGS
        ESP_LOGI("DEMO", "demo mode -> %s", g_demo_mode ? "ON" : "OFF");
    #endif
}

//-------------------------last-screen persistence-------------------------//
// Remembers which of the three swipeable screens (MainSpeedo/OtherData/RPMAFR)
// was on-screen when the unit was last powered off, so boot returns there
// instead of always landing on MainSpeedo. Screen-change events fire from
// SquareLine-generated swipe handlers already wired up in ui_MainSpeedo.c/
// ui_OtherData.c/ui_RPMAFR.c, so rather than editing those (they get
// overwritten on every SquareLine re-export), this listens for LVGL's own
// LV_EVENT_SCREEN_LOADED event, which _ui_screen_change()'s lv_screen_load_anim()
// fires on any screen change regardless of what triggered it.
#define UI_STATE_NAMESPACE "ui_state"
#define UI_STATE_KEY_SCREEN "last_screen"

typedef enum {
    UI_SCREEN_MAIN_SPEEDO = 0,
    UI_SCREEN_OTHER_DATA  = 1,
    UI_SCREEN_RPMAFR      = 2,
} ui_screen_id_t;

static nvs_handle_t ui_state_handle;

// Assumes nvs_flash_init() has already run (odometer_init() does this at boot).
static void ui_state_init(void) {
    ESP_ERROR_CHECK(nvs_open(UI_STATE_NAMESPACE, NVS_READWRITE, &ui_state_handle));
}

static ui_screen_id_t ui_state_load_last_screen(void) {
    uint8_t screen_id = UI_SCREEN_MAIN_SPEEDO;
    nvs_get_u8(ui_state_handle, UI_STATE_KEY_SCREEN, &screen_id);
    if (screen_id > UI_SCREEN_RPMAFR) screen_id = UI_SCREEN_MAIN_SPEEDO;
    return (ui_screen_id_t)screen_id;
}

// Logs every screen change (diagnostic breadcrumb - lets a lockup/hang be
// correlated with exactly which screen it happened on/near) and, for the
// three swipeable gauge screens only, persists it as the boot-to screen.
// Settings is intentionally not persisted - booting straight to a menu
// instead of a gauge screen would be a worse default than always landing
// on MainSpeedo/whatever gauge screen was last active.
static void screen_loaded_cb(lv_event_t *e) {
    lv_obj_t *screen = lv_event_get_target(e);
    const char *screen_name;
    bool persist = true;
    uint8_t screen_id = 0;

    if (screen == ui_MainSpeedo)      { screen_name = "MainSpeedo"; screen_id = UI_SCREEN_MAIN_SPEEDO; }
    else if (screen == ui_OtherData)  { screen_name = "OtherData";  screen_id = UI_SCREEN_OTHER_DATA; }
    else if (screen == ui_RPMAFR)     { screen_name = "RPMAFR";     screen_id = UI_SCREEN_RPMAFR; }
    else if (screen == ui_Settings)   { screen_name = "Settings";   persist = false; }
    else                              { screen_name = "unknown";   persist = false; }

    #if ENABLE_LOGS
        ESP_LOGI("SCREEN", "-> %s", screen_name);
    #endif

    if (!persist) return;

    nvs_set_u8(ui_state_handle, UI_STATE_KEY_SCREEN, screen_id);
    nvs_commit(ui_state_handle);
}
//----------------------------------------------------------------------------//

// One-shot timer callback: switches from BootScreen to whichever screen was
// last selected (see ui_state_load_last_screen()), kicking off the needle
// sweep only when that screen is MainSpeedo.
static void boot_to_last_screen_cb(lv_timer_t *timer) {
    lv_timer_del(timer);

    switch (ui_state_load_last_screen()) {
        case UI_SCREEN_OTHER_DATA:
            _ui_screen_change(&ui_OtherData, LV_SCREEN_LOAD_ANIM_FADE_ON, 100, 0, &ui_OtherData_screen_init);
            break;
        case UI_SCREEN_RPMAFR:
            _ui_screen_change(&ui_RPMAFR, LV_SCREEN_LOAD_ANIM_FADE_ON, 100, 0, &ui_RPMAFR_screen_init);
            break;
        default:
            _ui_screen_change(&ui_MainSpeedo, LV_SCREEN_LOAD_ANIM_FADE_ON, 100, 0, &ui_MainSpeedo_screen_init);
            // g_demo_mode always starts false (see its declaration), so this
            // always wants the real boot sweep at this point regardless.
            start_speedo_boot_sweep();
            break;
    }
}

//-------------------------SD card: crash-dump relay + debug log mirroring-------------------------//
// No card-detect pin on this hardware (see CLAUDE.md's open hardware items), so
// "mounted" is determined purely by bsp_sdcard_mount()'s return code - every
// caller here must tolerate it failing (no card inserted, or a card fault) and
// just skip the SD-dependent feature rather than block boot on it.
#if SD_FEATURES_ENABLED
#define DEBUG_LOG_PATH  BSP_SD_MOUNT_POINT "/dashrpm_debug.log"

// Copies a pending flash core dump out to a uniquely-numbered file on the SD
// card, then erases it from flash so it isn't copied again next boot. The
// dump itself is captured to the dedicated "coredump" flash partition (see
// partitions.csv) at crash time, not directly to SD - flash is always present
// and doesn't depend on a card happening to be inserted, or on SDMMC/FATFS
// being in a working state right after a crash. This function only runs the
// one-time "relay it somewhere retrievable" step, well after boot succeeds.
static void relay_coredump_to_sd(void) {
    if (esp_core_dump_image_check() != ESP_OK) return;   // nothing pending

    size_t addr = 0, size = 0;
    if (esp_core_dump_image_get(&addr, &size) != ESP_OK || size == 0) return;

    // Sequence number so successive crash dumps don't overwrite each other -
    // stored in NVS since flash survives when the SD card doesn't.
    uint32_t seq = 0;
    nvs_handle_t nvs;
    esp_err_t nvs_err = nvs_open("crashlog", NVS_READWRITE, &nvs);
    if (nvs_err == ESP_OK) {
        nvs_get_u32(nvs, "seq", &seq);
        seq++;
        esp_err_t set_err = nvs_set_u32(nvs, "seq", seq);
        esp_err_t commit_err = nvs_commit(nvs);
        nvs_close(nvs);
        if (set_err != ESP_OK || commit_err != ESP_OK) {
            ESP_LOGW("COREDUMP", "Failed to persist crash sequence number (set=%s commit=%s) - "
                     "next dump may overwrite this one", esp_err_to_name(set_err), esp_err_to_name(commit_err));
        }
    } else {
        ESP_LOGW("COREDUMP", "Failed to open crashlog NVS namespace (%s) - "
                 "sequence number will reset to 1 and may overwrite an existing dump", esp_err_to_name(nvs_err));
    }

    char path[64];
    snprintf(path, sizeof(path), BSP_SD_MOUNT_POINT "/coredump_%04lu.elf", (unsigned long)seq);

    FILE *f = fopen(path, "wb");
    if (!f) {
        ESP_LOGW("COREDUMP", "Found a pending core dump but couldn't open %s to relay it", path);
        return;
    }

    uint8_t buf[512];
    size_t remaining = size;
    bool ok = true;
    while (remaining > 0) {
        size_t chunk = remaining < sizeof(buf) ? remaining : sizeof(buf);
        if (esp_flash_read(esp_flash_default_chip, buf, addr, chunk) != ESP_OK ||
            fwrite(buf, 1, chunk, f) != chunk) {
            ok = false;
            break;
        }
        addr += chunk;
        remaining -= chunk;
    }
    fclose(f);

    if (ok) {
        ESP_LOGW("COREDUMP", "Relayed a crash dump to %s", path);
        esp_core_dump_image_erase();   // clear the flash slot now it's safely on SD
    } else {
        ESP_LOGW("COREDUMP", "Relay to %s failed partway through - leaving flash copy intact", path);
        remove(path);
    }
}

#if ENABLE_LOGS
static FILE *s_debug_log_file = NULL;

// Queue of formatted log lines, drained by debug_log_writer_task() below.
// debug_log_tee_vprintf() runs synchronously on whatever task calls
// ESP_LOGx - including taskLVGL itself, from LVGL event callbacks like
// ChangeDemoMode()/screen_loaded_cb(). Doing the actual SD write there
// directly (even throttled) blocks that task on the write for however long
// it takes - confirmed on the bench as touch/swipe becoming unresponsive
// for a long stretch (and, once, an apparent full lockup) right at the
// moment a log line landed on the ~1s fsync() window. SD cards can stall
// for hundreds of ms to seconds during internal wear-leveling/GC, and
// there's no way to bound that from the caller's side - so instead the
// hook only ever does a cheap, non-blocking queue push (drops the line if
// the queue's full, rather than ever blocking the caller), and a dedicated
// low-priority task owns all the actual file I/O.
#define DEBUG_LOG_LINE_MAX   160
#define DEBUG_LOG_QUEUE_DEPTH 32
static QueueHandle_t s_debug_log_queue = NULL;

// esp_log_set_vprintf() installs debug_log_tee_vprintf as the live log hook
// and returns the previous one in the same call - there's an inherent window
// on SMP where another task can already be inside the new hook before that
// return value lands in s_original_vprintf below. Defaulting to plain libc
// vprintf (instead of NULL) means a log line hitting that window still goes
// out on the console instead of crashing on a NULL call.
static vprintf_like_t s_original_vprintf = vprintf;

// Tees every line that goes through the IDF log system (ESP_LOGx, plus IDF's
// own internal logging) to both the normal UART console and the SD card
// file, exactly mirroring what idf.py monitor shows. Never touches the SD
// card itself (see s_debug_log_queue's comment) - just a non-blocking queue
// push of the formatted line, so this is always cheap regardless of what
// the writer task is doing.
static int debug_log_tee_vprintf(const char *fmt, va_list args) {
    va_list args_copy;
    va_copy(args_copy, args);
    int ret = s_original_vprintf(fmt, args);
    if (s_debug_log_queue) {
        char line[DEBUG_LOG_LINE_MAX];
        vsnprintf(line, sizeof(line), fmt, args_copy);
        // 0 timeout: drop the line rather than ever block the calling task -
        // losing an occasional debug line is fine, stalling taskLVGL (or any
        // other task) on a full queue is not.
        xQueueSend(s_debug_log_queue, line, 0);
    }
    va_end(args_copy);
    return ret;
}

// Owns all SD file I/O for the debug log - the only place that ever calls
// vfprintf()/fflush()/fsync() on s_debug_log_file, entirely off whatever
// task actually logged (see debug_log_tee_vprintf()). Low priority: this is
// a best-effort debug artifact, never something the rest of the app should
// wait on.
static void debug_log_writer_task(void *arg) {
    char line[DEBUG_LOG_LINE_MAX];
    int64_t last_flush_us = 0;

    while (1) {
        // Blocks here for up to 1s - either a line arrives (write it) or the
        // wait times out (fall through to the periodic flush/sync check
        // below regardless, so a quiet period still gets synced promptly).
        if (xQueueReceive(s_debug_log_queue, line, pdMS_TO_TICKS(1000)) == pdTRUE) {
            fputs(line, s_debug_log_file);
        }

        // fflush() alone isn't enough: it only pushes C stdio's buffer down
        // to FATFS, not FATFS's own dirty sectors and directory entry (file
        // size) out to the physical card. This file is never closed during
        // normal operation (no clean-shutdown signal exists - same gap
        // noted for the odometer in CLAUDE.md Sec.9), so without an
        // explicit fsync() the card can show a 0-byte file even after many
        // fflush()es - confirmed on the bench, file existed but was empty.
        int64_t now_us = esp_timer_get_time();
        if (now_us - last_flush_us >= 1000000) {
            fflush(s_debug_log_file);
            fsync(fileno(s_debug_log_file));
            last_flush_us = now_us;
        }
    }
}

// Fresh log file each boot (overwrites the last one) - copy it off the card
// between debug sessions if you want to keep history from more than one.
static void debug_log_to_sd_init(void) {
    s_debug_log_file = fopen(DEBUG_LOG_PATH, "w");
    if (!s_debug_log_file) {
        ESP_LOGW("DEBUGLOG", "Couldn't open %s - continuing without file logging", DEBUG_LOG_PATH);
        return;
    }
    s_debug_log_queue = xQueueCreate(DEBUG_LOG_QUEUE_DEPTH, DEBUG_LOG_LINE_MAX);
    if (!s_debug_log_queue) {
        ESP_LOGW("DEBUGLOG", "Couldn't create log queue - continuing without file logging");
        fclose(s_debug_log_file);
        s_debug_log_file = NULL;
        return;
    }
    xTaskCreatePinnedToCore(debug_log_writer_task, "debug_log_writer", 4096, NULL, 2, NULL, 0);
    s_original_vprintf = esp_log_set_vprintf(debug_log_tee_vprintf);
}
#endif
#endif // SD_FEATURES_ENABLED

void app_main(void) {
    // Boot sequence: display/LVGL first, then hardware inputs, persistent
    // odometer state, UI construction, UARTs, and finally the data-source tasks.
    setenv("TZ", NZ_TZ, 1);
    tzset();

    bsp_display_cfg_t cfg = {
        .lvgl_port_cfg = ESP_LVGL_PORT_INIT_CONFIG(),
        .buffer_size = BSP_LCD_DRAW_BUFF_SIZE,
        .double_buffer = BSP_LCD_DRAW_BUFF_DOUBLE,
        .flags = {
            .buff_dma = true,
            .buff_spiram = false,
            .sw_rotate = false,
        }
    };
    bsp_display_start_with_config(&cfg);

    // bsp_display_backlight_off() is just bsp_display_brightness_set(0) - the
    // same call update_brightness() (via gauge_timer, created below) also
    // makes. Setting it here, before gauge_timer exists, means there's only
    // ever one writer to brightness at a time: 0% now to hide any initial
    // garbage frame, then update_brightness() takes over completely once it
    // starts ticking and brings it up to the correct day/night level itself.
    bsp_display_backlight_off();
    vTaskDelay(pdMS_TO_TICKS(100));

    adc_global_init();
    odometer_init();

    // SD card is best-effort - no card-detect pin, so a failed mount (no card,
    // or a card fault) just means the two features below silently don't run.
    #if SD_FEATURES_ENABLED
        {
            esp_err_t sd_err = bsp_sdcard_mount();
            if (sd_err == ESP_OK) {
                relay_coredump_to_sd();
                #if ENABLE_LOGS
                    debug_log_to_sd_init();
                #endif
            } else {
                ESP_LOGW("SDCARD", "Mount failed (%s) - no card, wrong format, or card fault. "
                         "Crash-dump relay and debug log-to-SD won't run this boot. "
                         "Card must be FAT32/exFAT with an MBR partition table (not GPT).",
                         esp_err_to_name(sd_err));
            }
        }
    #endif

    // AFR power gate output - held low (disabled) until the RPM gate
    // qualifies (see update_afr_power_gate()).
    gpio_set_direction(AFR_ENABLE_GPIO, GPIO_MODE_OUTPUT);
    gpio_set_level(AFR_ENABLE_GPIO, 0);

    // Headlight sense input - open-collector opto with an external pull-up
    // already on board (R18), so this internal one is redundant when the
    // carrier board is connected. It matters on the bench with the carrier
    // board unplugged: without it GPIO50 floats and can read LOW, which looks
    // like "headlights on" and forces night brightness during dev/debug.
    gpio_set_direction(HEADLIGHT_GPIO, GPIO_MODE_INPUT);
    gpio_set_pull_mode(HEADLIGHT_GPIO, GPIO_PULLUP_ONLY);

    rpm_pcnt_init();

    ui_init();
    demo_badge_init();
    ui_state_init();
    lv_obj_add_event_cb(ui_MainSpeedo, screen_loaded_cb, LV_EVENT_SCREEN_LOADED, NULL);
    lv_obj_add_event_cb(ui_OtherData, screen_loaded_cb, LV_EVENT_SCREEN_LOADED, NULL);
    lv_obj_add_event_cb(ui_RPMAFR, screen_loaded_cb, LV_EVENT_SCREEN_LOADED, NULL);
    lv_obj_add_event_cb(ui_Settings, screen_loaded_cb, LV_EVENT_SCREEN_LOADED, NULL);
    // Screens are created once and persist (see _ui_screen_change() in
    // ui_helpers.c - it only calls target_init() the first time), so
    // ui_DemoSwitch is never recreated on revisit and needs no re-sync here.
    lv_obj_add_event_cb(ui_DemoSwitch, demo_switch_value_changed_cb, LV_EVENT_VALUE_CHANGED, NULL);

    lv_timer_create(gauge_timer, 10, NULL);
    lv_timer_create(boot_to_last_screen_cb, 2000, NULL);


    xTaskCreatePinnedToCore(save_miles_task, "save_miles_task", 4096, NULL, 4, NULL, 0);

    // All four always run now - g_demo_mode (runtime, via ui_DemoSwitch) picks
    // which one's writes actually reach g_gauge_data, not which tasks exist.
    // See adc_task/gps_task/afr_task/demo_task for the per-field gating.
    xTaskCreatePinnedToCore(demo_task, "demo_task", 4096, NULL, 5, NULL, 0);

    xTaskCreatePinnedToCore(adc_task, "adc_task", 4096, NULL, 5, NULL, 0);

    uart_init(GPS_UART_NUM, GPS_TX_PIN, GPS_RX_PIN, (GPS_BUF_SIZE*2), GPS_BAUD_RATE);
    gps_ubx_query_chip_info(GPS_UART_NUM);
    xTaskCreatePinnedToCore(gps_task, "gps_task", 4096, NULL, 5, NULL, 0);

    uart_init(AFR_UART_NUM, AFR_TX_PIN, AFR_RX_PIN, 256, AFR_BAUD_RATE);
    xTaskCreatePinnedToCore(afr_task, "afr_task", 4096, NULL, 5, NULL, 0);
}
