dattewell/center-cluster-esp32-p4/main/gps_wrap/gps_wrapper.h

#pragma once
#include <stdbool.h>
#include <stdint.h>
#include "driver/uart.h"

#ifdef __cplusplus
extern "C" {
#endif

// C-facing wrapper around TinyGPS++.  The parser itself is C++, but the rest of
// the firmware can stay in C by using this API.

/* =======================
   FEED GPS
   ======================= */

void gps_encode_char(char c);

/* =======================
   SPEED
   ======================= */

// True when TinyGPS++ has parsed a new speed field since the last check.
int   gps_speed_updated(void);

// Vehicle speed in MPH, or 0.0f when the speed field is invalid.
float gps_get_speed_mph(void);

/* =======================
   FIX STATUS
   ======================= */

// A fix is valid only while the location is both valid and recent.
bool  gps_has_fix(void);

// Satellites used by the current fix, or 0 when unknown.
int   gps_sats_used(void);

// Horizontal dilution of precision; lower is better, -1 means unavailable.
float gps_hdop(void);

/* =======================
   LOCATION ACCESS
   ======================= */

// True when a new location was parsed from the stream.
bool   gps_location_updated(void);

// Raw TinyGPS++ validity flag for the current location.
bool   gps_location_valid(void);

double gps_get_lat(void);
double gps_get_lon(void);

// Course over ground in degrees, or 0.0f when invalid.
float gps_get_course_deg(void);

/* =======================
   TIME (UTC)
   ======================= */

// True when TinyGPS++ has a valid parsed time field.
bool gps_time_valid(void);

// UTC hour/minute/second, or -1 each when the time field isn't valid yet.
int  gps_get_hour(void);
int  gps_get_minute(void);
int  gps_get_second(void);

// True when TinyGPS++ has a valid parsed date field.
bool gps_date_valid(void);

// UTC calendar date, or -1 each when the date field isn't valid yet.
int  gps_get_year(void);   // full year, e.g. 2026
int  gps_get_month(void);  // 1-12
int  gps_get_day(void);    // 1-31

/* =======================
   UBX (u-blox binary protocol)
   ======================= */

// Feed one raw byte from the same UART stream used for gps_encode_char() into
// the UBX frame parser. Harmless on non-UBX streams - it only reacts to the
// 0xB5 0x62 sync bytes and otherwise ignores everything, so it's safe to call
// on every byte alongside gps_encode_char() regardless of module type.
void gps_ubx_feed_byte(uint8_t b);

// Sends a fixed UBX-MON-VER poll on the given UART port, asking the module
// for its software/hardware version and identifying extension strings. Only
// u-blox / UBX-compatible chips will respond; others silently ignore it. The
// response is picked up by gps_ubx_feed_byte() and logged automatically once
// a full, checksum-valid MON-VER reply is captured.
void gps_ubx_query_chip_info(uart_port_t uart_num);

/* =======================
   DISTANCE
   ======================= */

// Great-circle distance in meters between two WGS84 coordinates.
double gps_distance_between(double lat1,
                            double lon1,
                            double lat2,
                            double lon2);

#ifdef __cplusplus
}
#endif
