dattewell/center-cluster-esp32-p4/(commit log)

2026-04-02 fix: adding boost and afr to main gauge
    [main.c]
2026-07-01 modified: .DS_Store modified: .vscode/settings.json modified: dependencies.lock new file: e12b68b3-a991-4bbe-9218-925f4319bd1d.png modified: main/.DS_Store modified: main/canbus/canbus.c modified: ma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
2026-07-16 modified: main/CMakeLists.txt deleted: main/canbus/canbus.c deleted: main/canbus/canbus.h deleted: main/canbus/protocol_list.h deleted: main/canbus/protocol_loader.c deleted: main/canbus/protocol_loa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
2026-07-27 modified: main/CMakeLists.txt modified: main/gps_wrap/gps_wrapper.cpp modified: main/gps_wrap/gps_wrapper.h modified: main/main.c modified: main/ui/CMakeLists.txt modified: main/ui/filelist.txt modif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
    [DashRPM.kicad_sch]
2026-08-12 new file: CLAUDE.md modified: main/main.c
    [DashRPM.kicad_pcb, DashRPM.kicad_sch]
2026-08-15 modified: CLAUDE.md modified: CMakeLists.txt modified: README.md modified: components/TinyGPSPlus-ESPIDF/CMakeLists.txt modified: components/TinyGPSPlus-ESPIDF/TinyGPSPlus/src/TinyGPS++.cpp modified: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
    [partitions.csv]
